gabrielDallape/minhoca-trail-system/hardware/placa_radio/saida/furos.csv

x_mm_lado_cobre | y_mm | broca_mm | o_que_e
31.00 | 3.40 | 1.0 | J3 entrada 5,3 V (-)
33.54 | 3.40 | 1.0 | J3 entrada 5,3 V (+)
4.00 | 5.00 | 0.8 | J2 pino 1 (TXEN)
6.00 | 5.00 | 0.8 | J2 pino 2 (NRST)
8.00 | 5.00 | 0.8 | J2 pino 3 (DIO1)
10.00 | 5.00 | 0.8 | J2 pino 4 (BUSY)
12.00 | 5.00 | 0.8 | J2 pino 5 (nao usado)
14.00 | 5.00 | 0.8 | J2 pino 6 (nao usado)
16.00 | 5.00 | 0.8 | J2 pino 7 (nao usado)
18.00 | 5.00 | 0.8 | J2 pino 8 (GND)
20.00 | 5.00 | 0.8 | J2 pino 9 (nao usado)
22.00 | 5.00 | 0.8 | J2 pino 10 (nao usado)
24.00 | 5.00 | 0.8 | J2 pino 11 (GND)
26.00 | 5.00 | 0.8 | J2 pino 12 (nao usado)
33.10 | 9.60 | 0.9 | C1 220uF (-)
35.60 | 9.60 | 0.9 | C1 220uF (+)
10.00 | 12.00 | 0.8 | JUMPER JP2 lado A (BUSY)
2.90 | 12.40 | 0.8 | JUMPER JP2 lado B (BUSY)
33.00 | 53.80 | 0.8 | JUMPER JP4 lado A (TERRA)
33.00 | 57.20 | 0.8 | JUMPER JP4 lado B (TERRA)
4.00 | 58.00 | 0.8 | J1 pino 1 (nao usado)
6.00 | 58.00 | 0.8 | J1 pino 2 (nao usado)
8.00 | 58.00 | 0.8 | J1 pino 3 (MISO)
10.00 | 58.00 | 0.8 | J1 pino 4 (SCK)
12.00 | 58.00 | 0.8 | J1 pino 5 (MOSI)
14.00 | 58.00 | 0.8 | J1 pino 6 (NSS)
16.00 | 58.00 | 0.8 | J1 pino 7 (RXEN)
18.00 | 58.00 | 0.8 | J1 pino 8 (GPS_TX)
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
