gabrielDallape/minhoca-trail-system/docs/img_lcd5_conectores.png

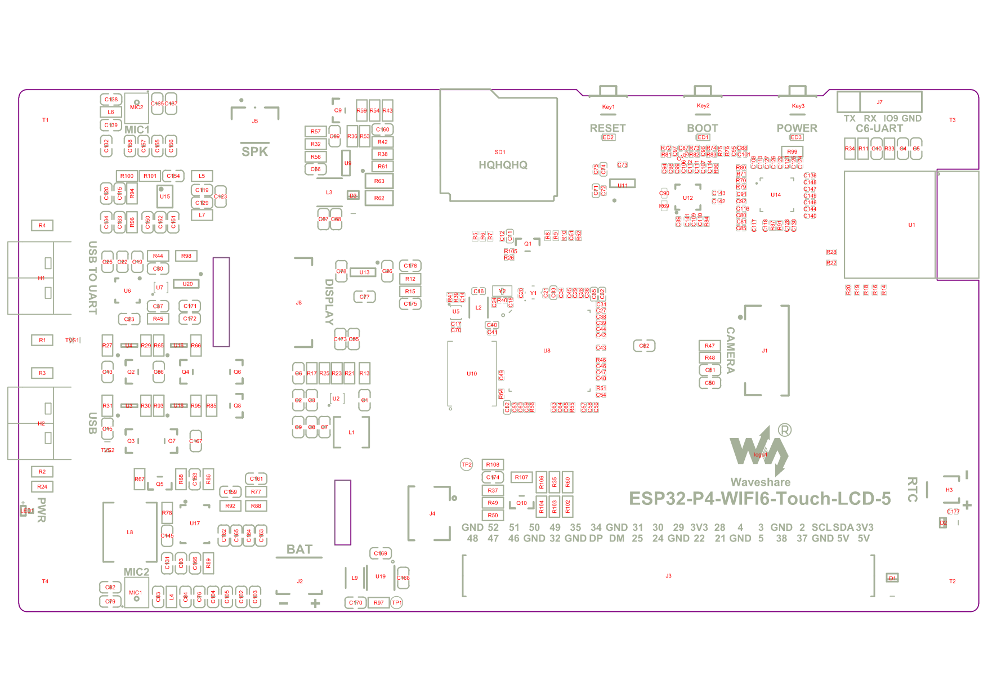
docs/img_lcd5_conectores.png
