gabrielDallape/minhoca-trail-system/docs/img_lcd7b_conectores.png

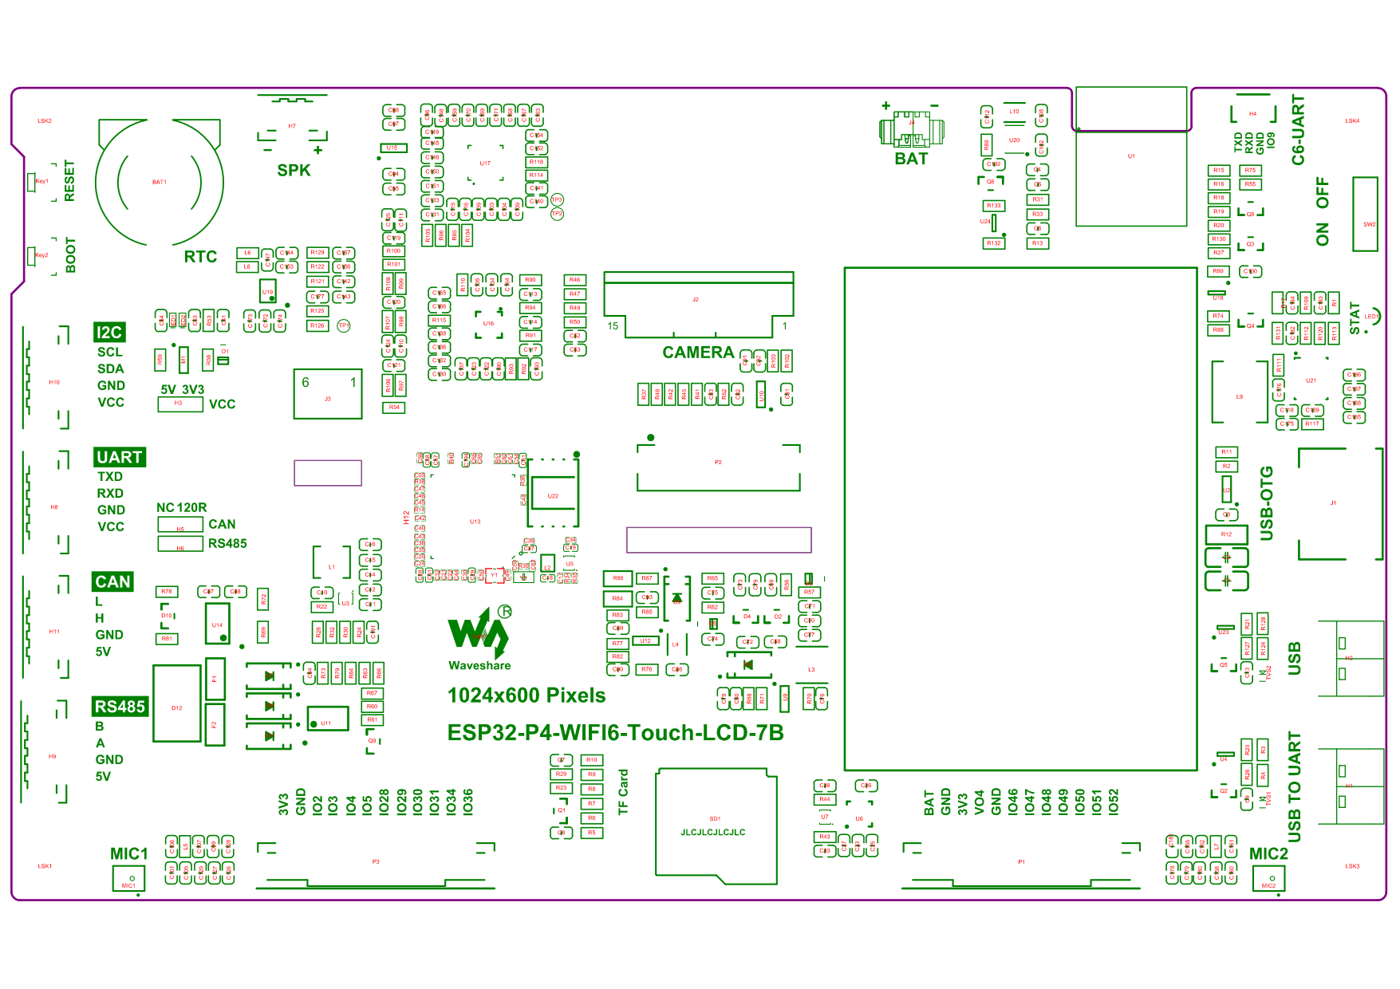
docs/img_lcd7b_conectores.png
