gabrielDallape/minhoca-trail-system/hardware/placa_radio/final/guia_4_placa_montada.png

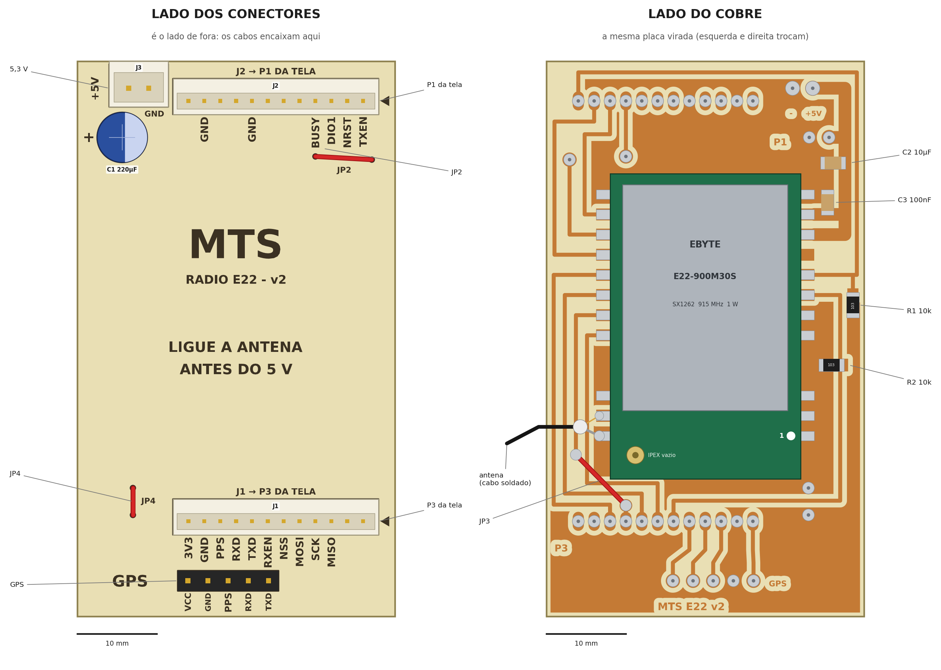
hardware/placa_radio/final/guia_4_placa_montada.png
