gabrielDallape/minhoca-trail-system/hardware/placa_radio/final/laser_queimar_bmp.bmp

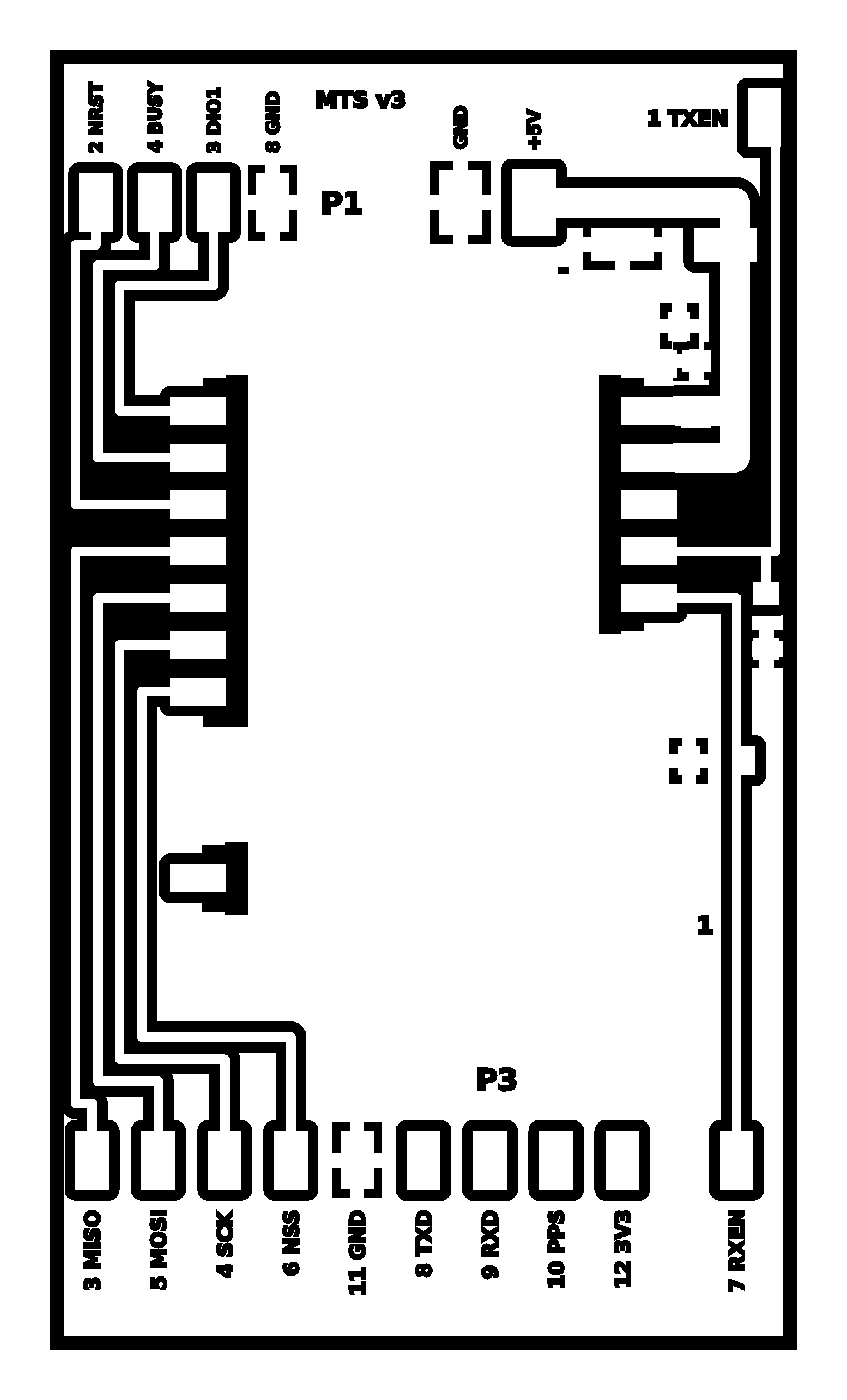
hardware/placa_radio/final/laser_queimar_bmp.bmp
