gabrielDallape/minhoca-trail-system/hardware/placa_radio/final/laser_serigrafia_bmp.bmp

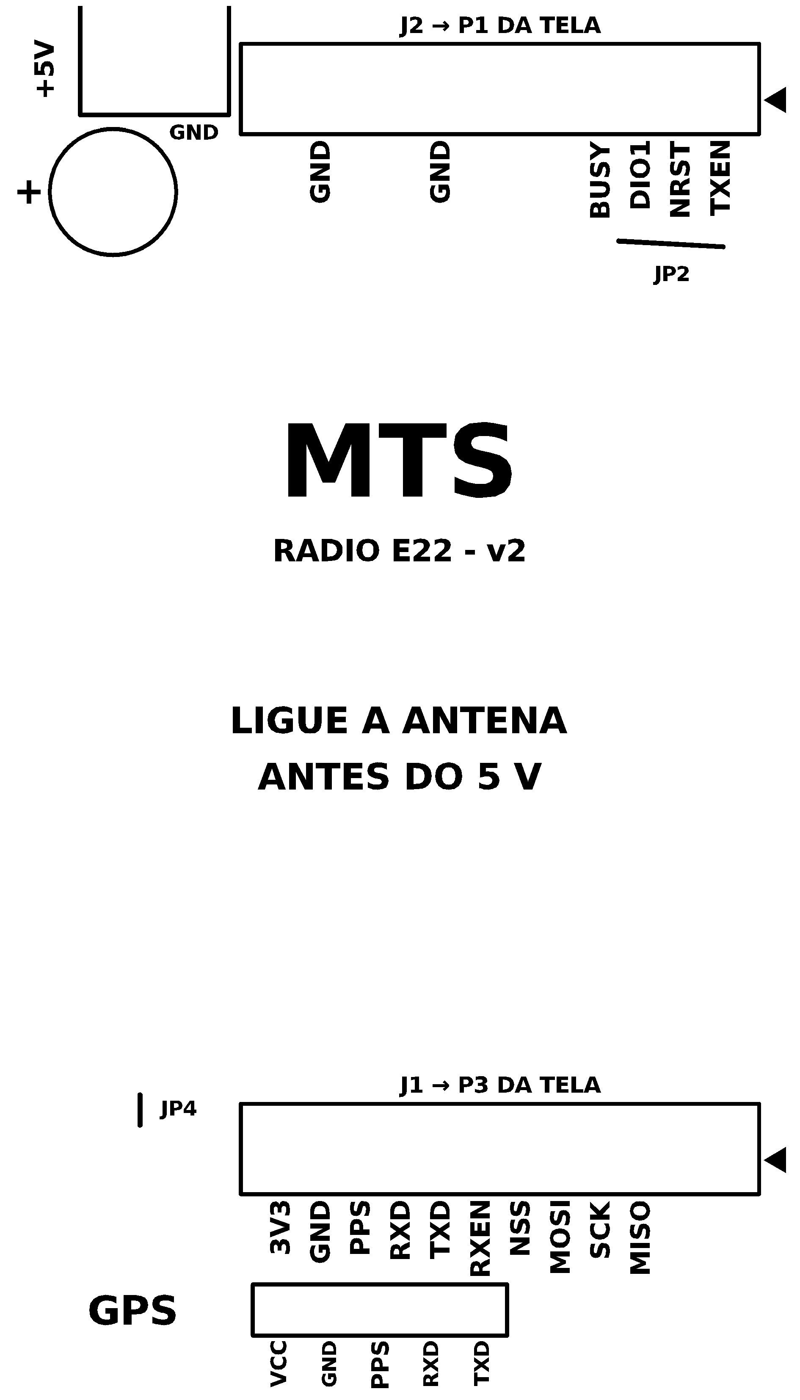
hardware/placa_radio/final/laser_serigrafia_bmp.bmp
