gabrielDallape/minhoca-trail-system/hardware/placa_radio/final/PREVIA_queimar_nao_gravar.png

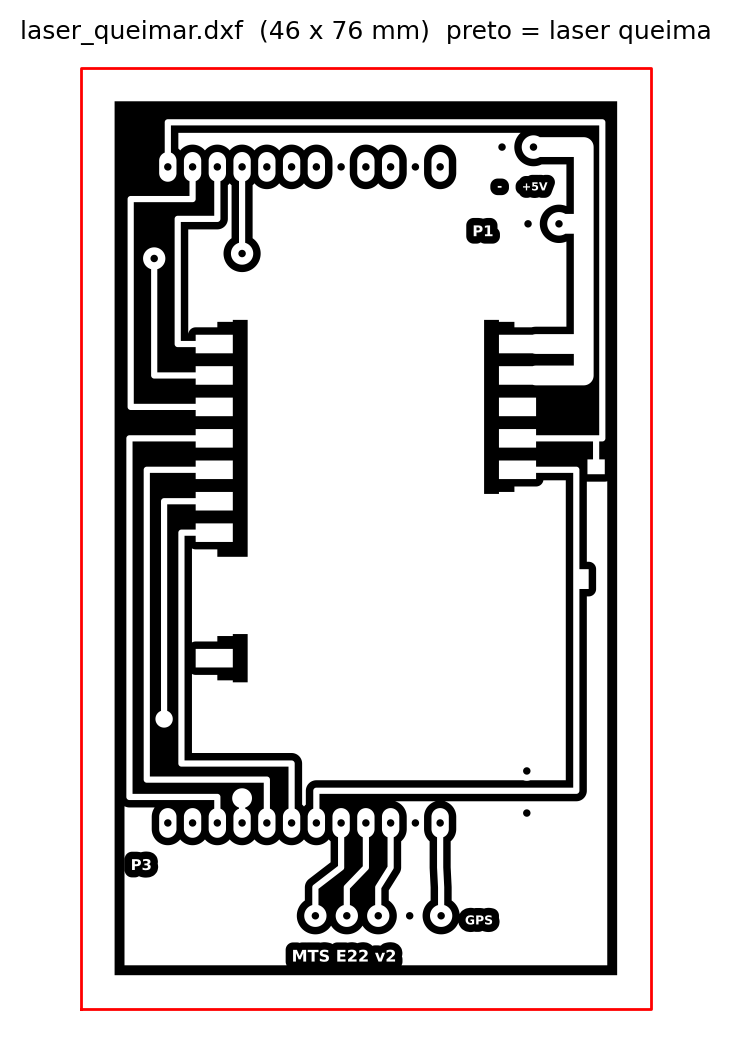
hardware/placa_radio/final/PREVIA_queimar_nao_gravar.png
