gabrielDallape/minhoca-trail-system/hardware/placa_radio/final/zoom_vao_e22.png

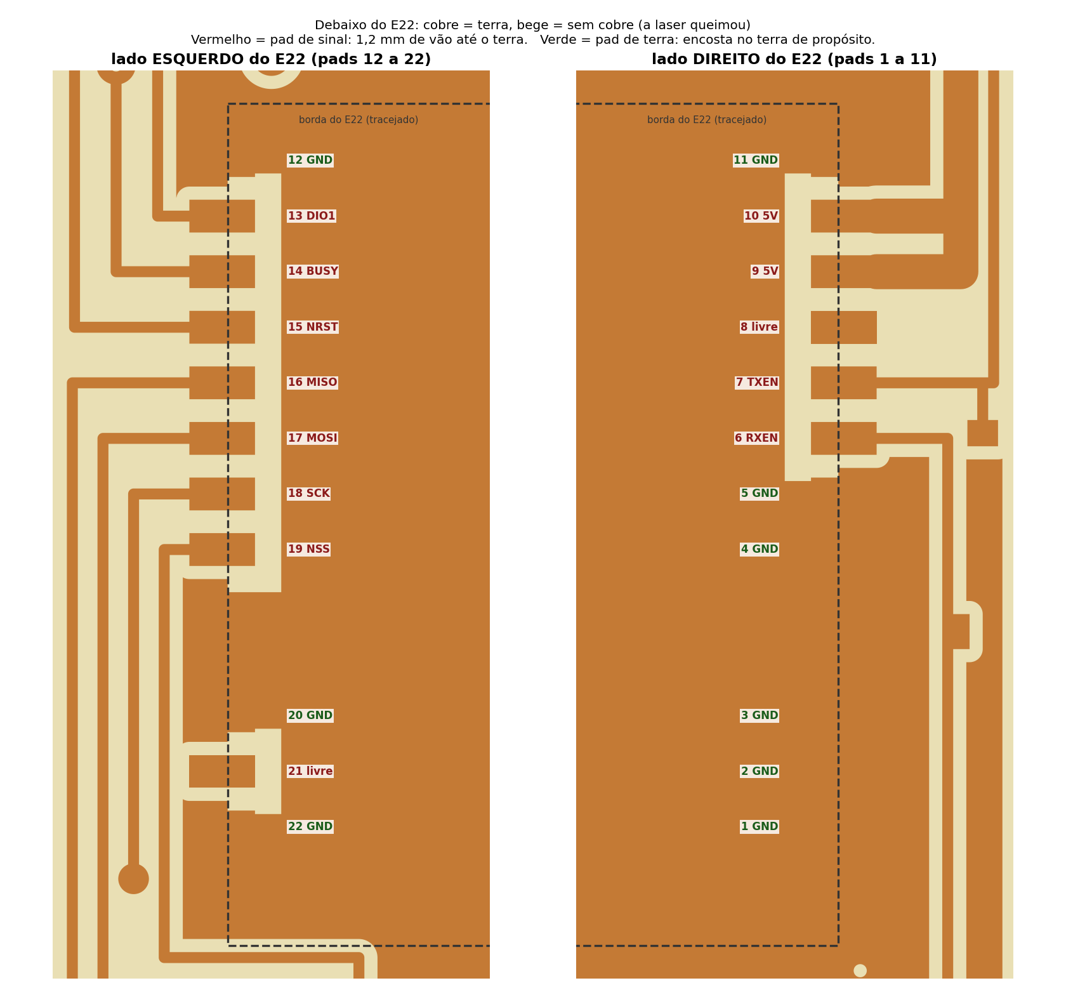
hardware/placa_radio/final/zoom_vao_e22.png
