gabrielDallape/minhoca-trail-system/hardware/placa_radio/saida/cobre.png

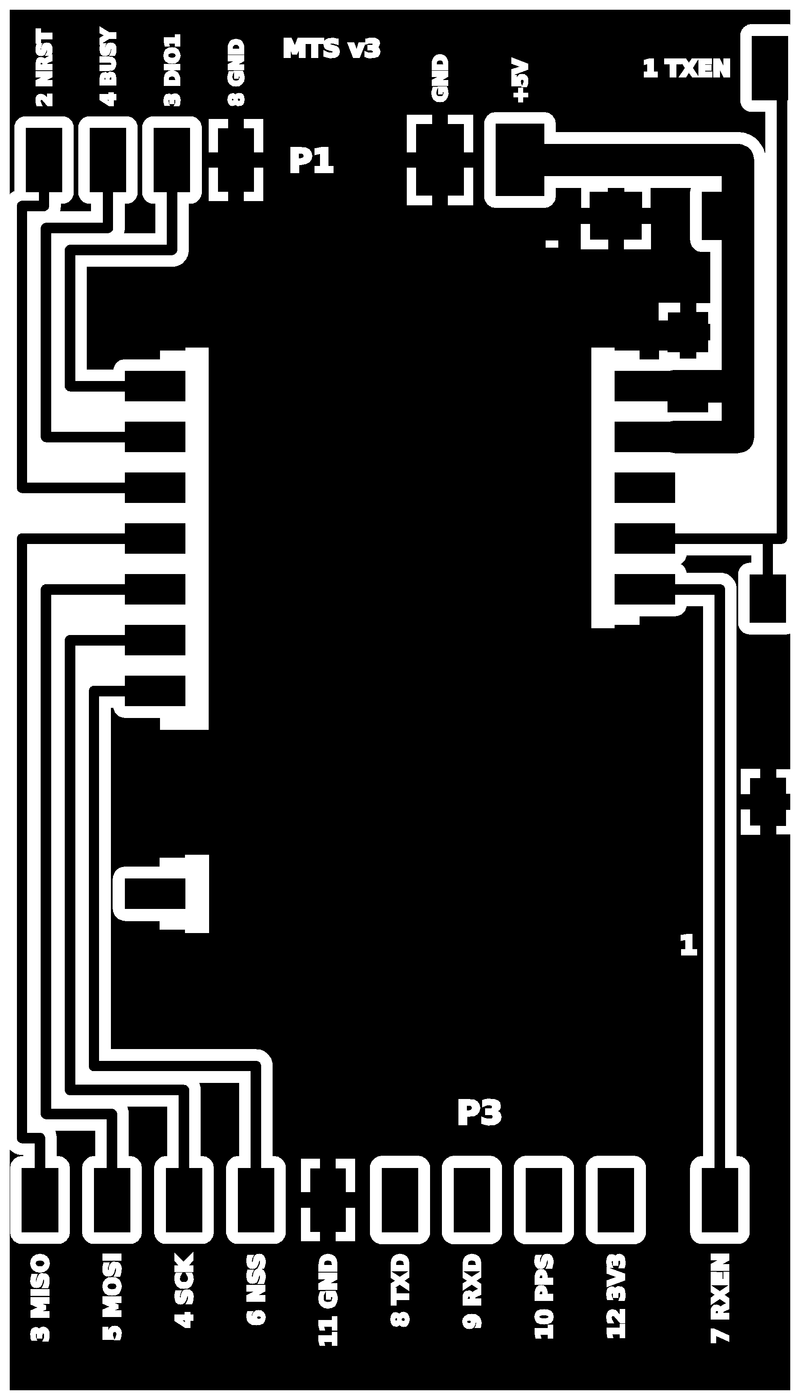
hardware/placa_radio/saida/cobre.png
