gabrielDallape/minhoca-trail-system/hardware/placa_radio/saida/conferencia_redes.png

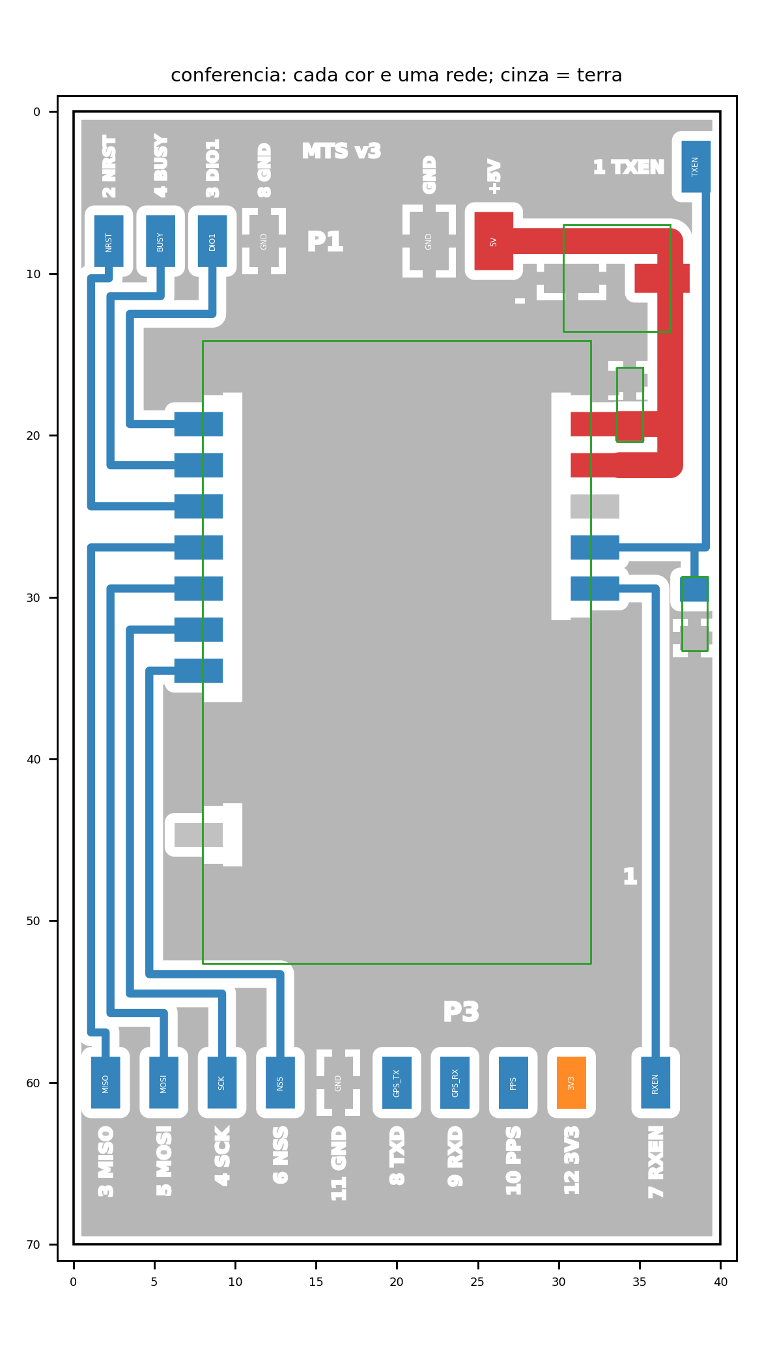
hardware/placa_radio/saida/conferencia_redes.png
