gabrielDallape/minhoca-trail-system/hardware/placa_radio/saida/guia_1_conectores.png

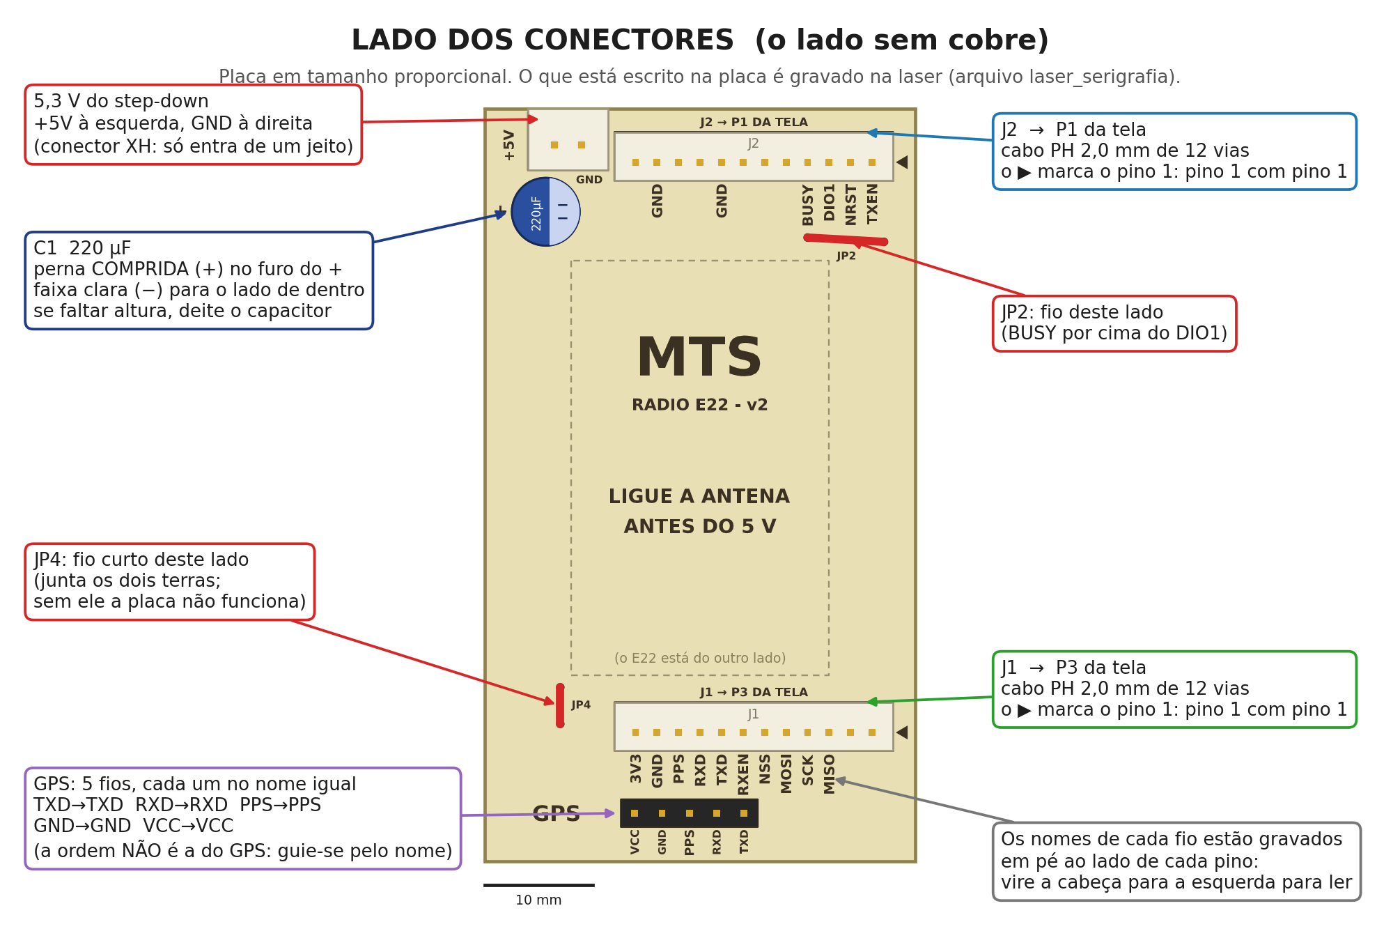
hardware/placa_radio/saida/guia_1_conectores.png
