gabrielDallape/minhoca-trail-system/hardware/placa_radio/saida/guia_2_lado_do_cobre.png

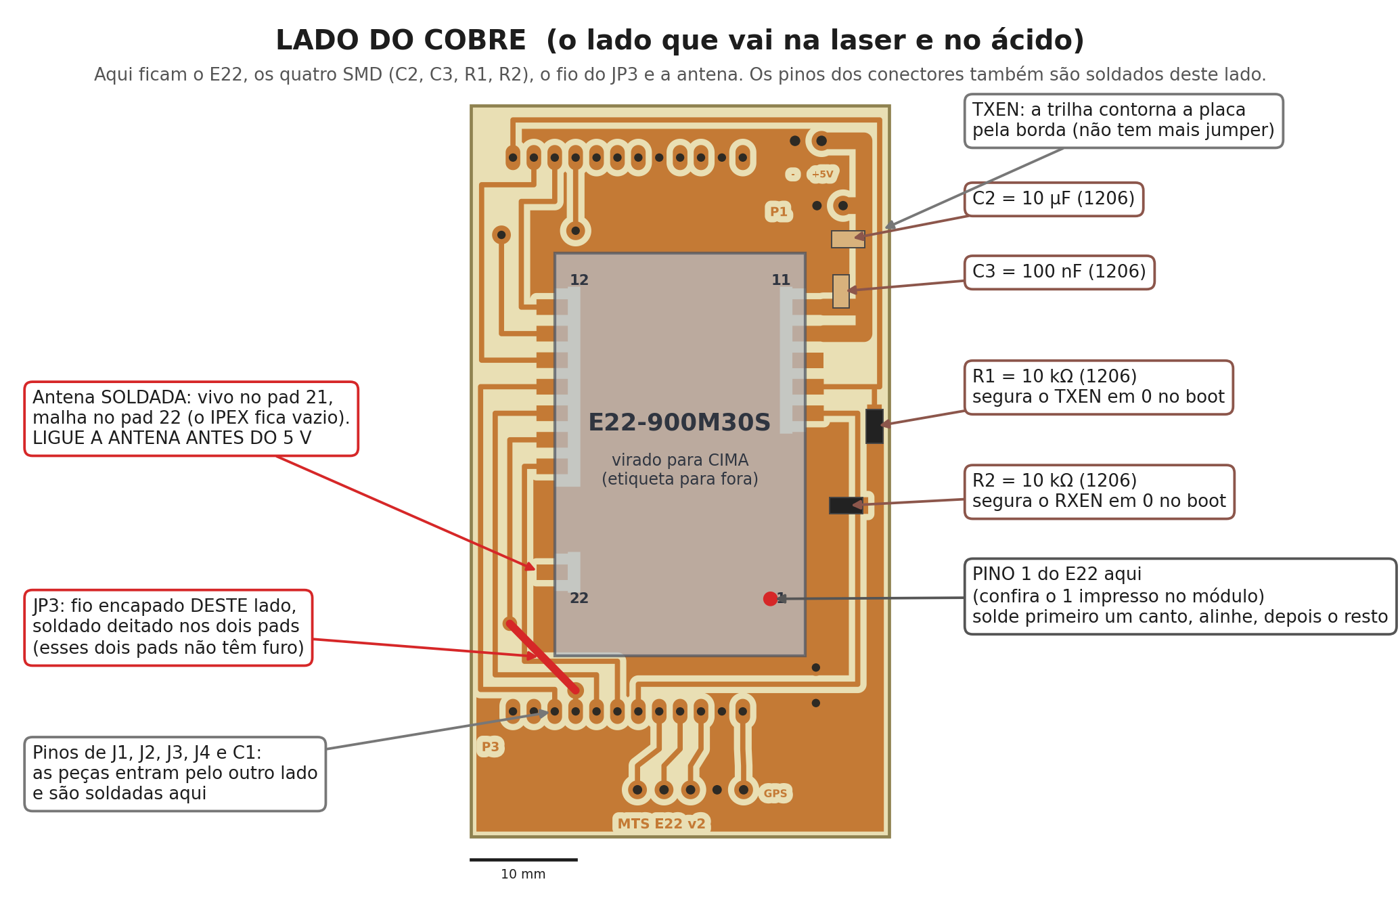
hardware/placa_radio/saida/guia_2_lado_do_cobre.png
