gabrielDallape/minhoca-trail-system/hardware/placa_radio/saida/guia_3_ligacoes.png

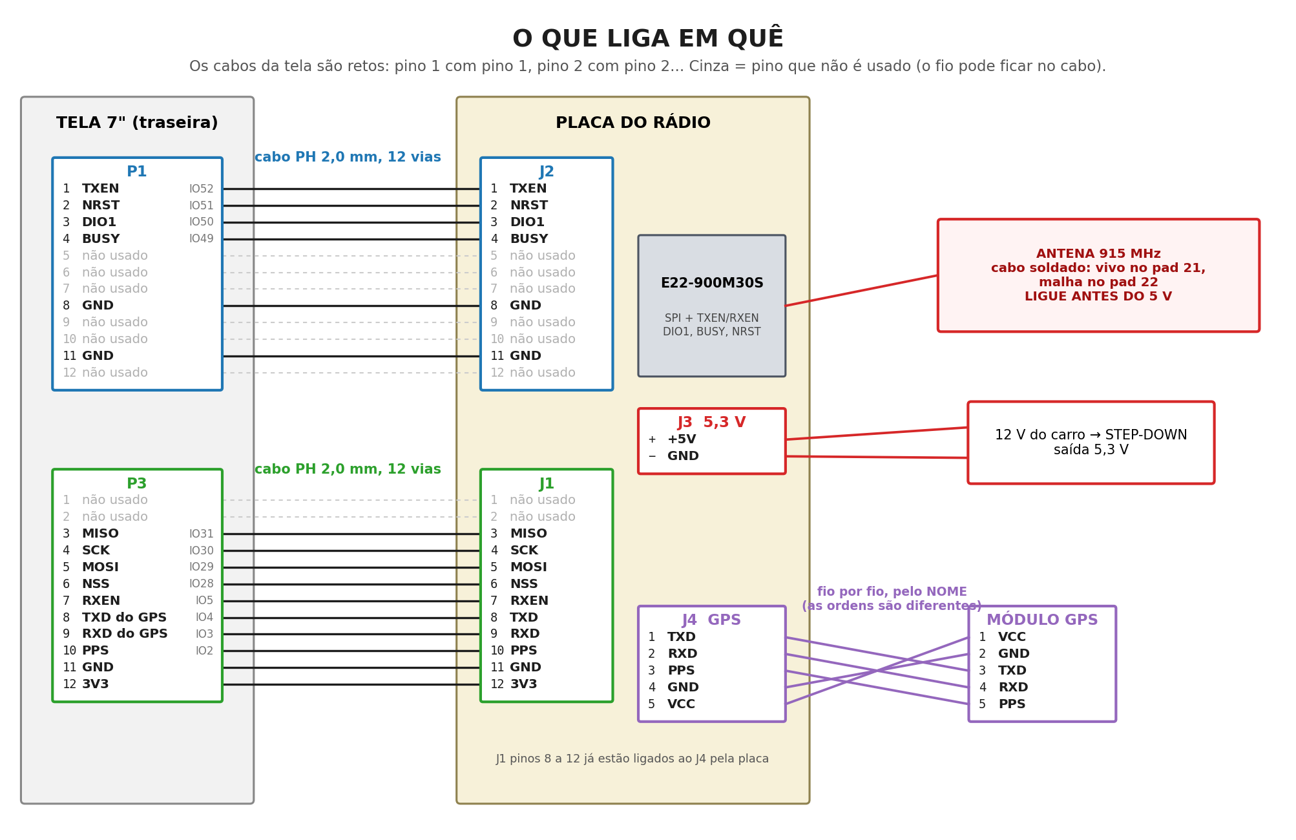
hardware/placa_radio/saida/guia_3_ligacoes.png
