gabrielDallape/minhoca-trail-system/hardware/placa_radio/saida/preview_laser_queimar_dxf.png

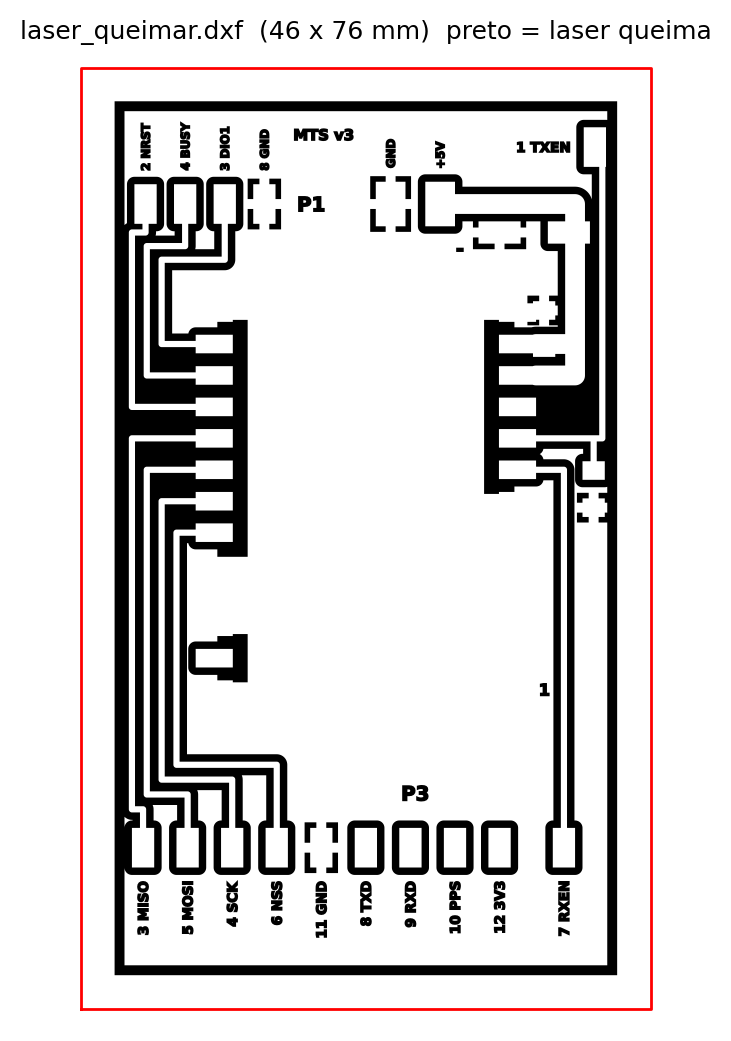
hardware/placa_radio/saida/preview_laser_queimar_dxf.png
