gabrielDallape/minhoca-trail-system/hardware/placa_radio/saida/preview_laser_serigrafia_dxf.png

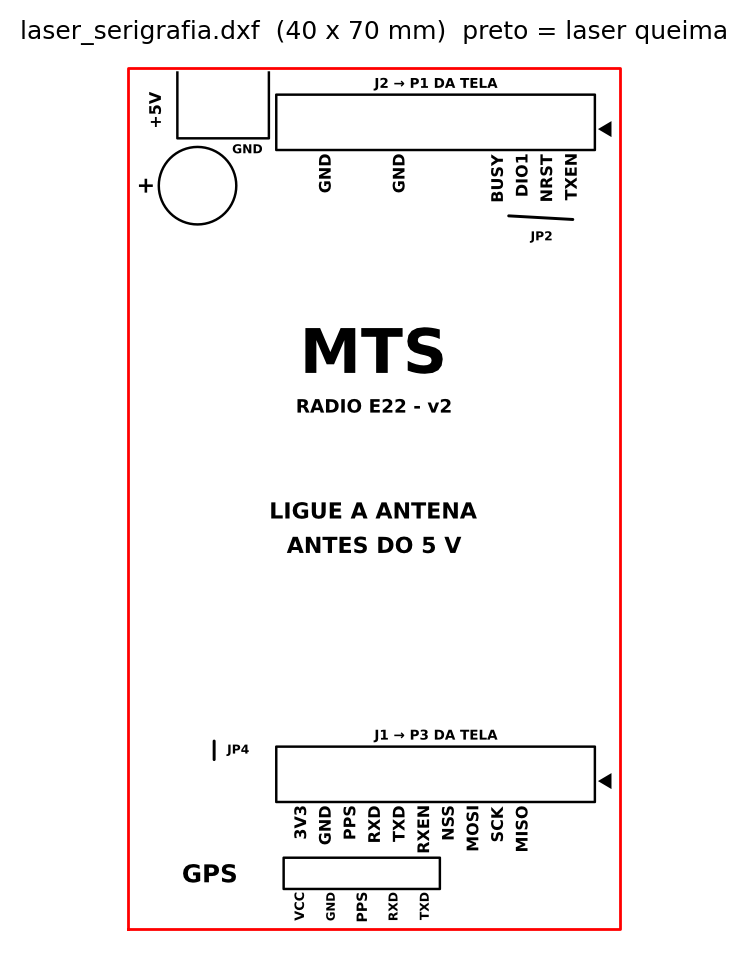
hardware/placa_radio/saida/preview_laser_serigrafia_dxf.png
