gabrielDallape/minhoca-trail-system/hardware/placa_radio/saida/regua_100mm.png

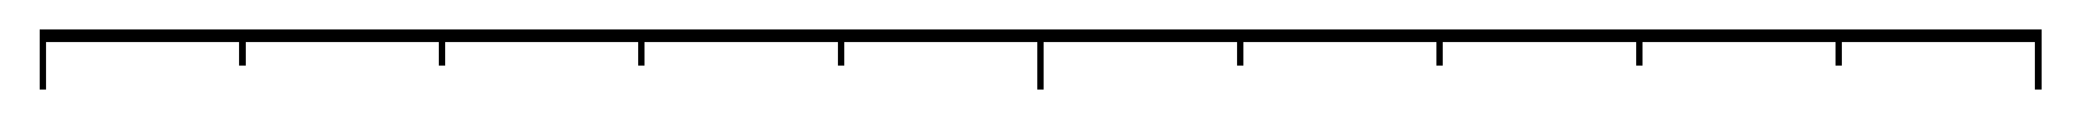
hardware/placa_radio/saida/regua_100mm.png
