gabrielDallape/minhoca-trail-system/hardware/placa_radio/final/laser_queimar.dxf

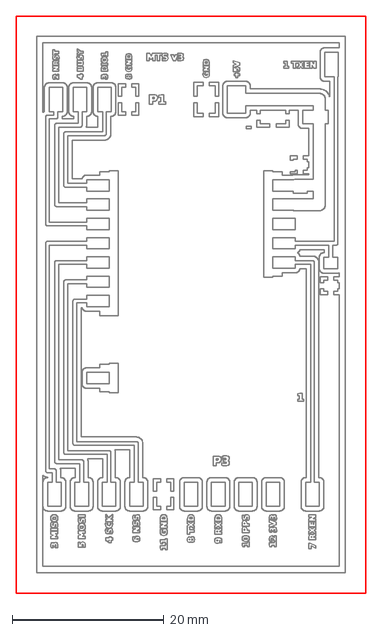
[picture p16: CAD file, 2026-10-02]
hardware/placa_radio/final/laser_queimar.dxf
46.0 x 76.0 mm
