gabrielDallape/minhoca-trail-system/hardware/placa_radio/saida/laser_queimar.dxf

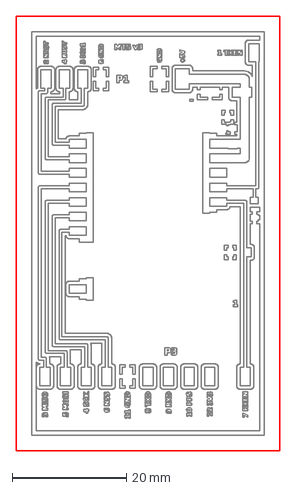
[picture p17: CAD file, 2026-10-02]
hardware/placa_radio/saida/laser_queimar.dxf
46.0 x 76.0 mm
