gabrielDallape/minhoca-trail-system/hardware/placa_radio/final/laser_serigrafia.dxf

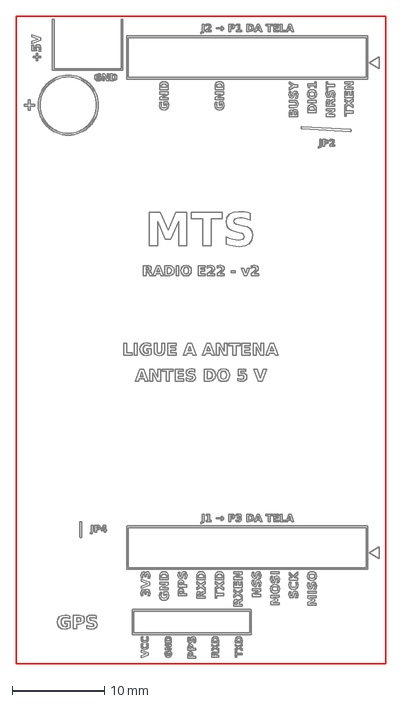
[picture p18: CAD file, 2026-10-01]
hardware/placa_radio/final/laser_serigrafia.dxf
40.0 x 70.0 mm
