gabrielDallape/minhoca-trail-system/hardware/placa_radio/saida/laser_serigrafia.dxf

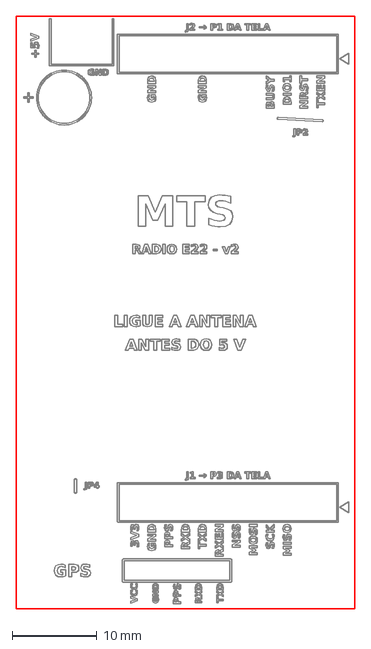
[picture p19: CAD file, 2026-10-01]
hardware/placa_radio/saida/laser_serigrafia.dxf
40.0 x 70.0 mm
