gabrielDallape/minhoca-trail-system/hardware/placa_radio/saida/montagem.png

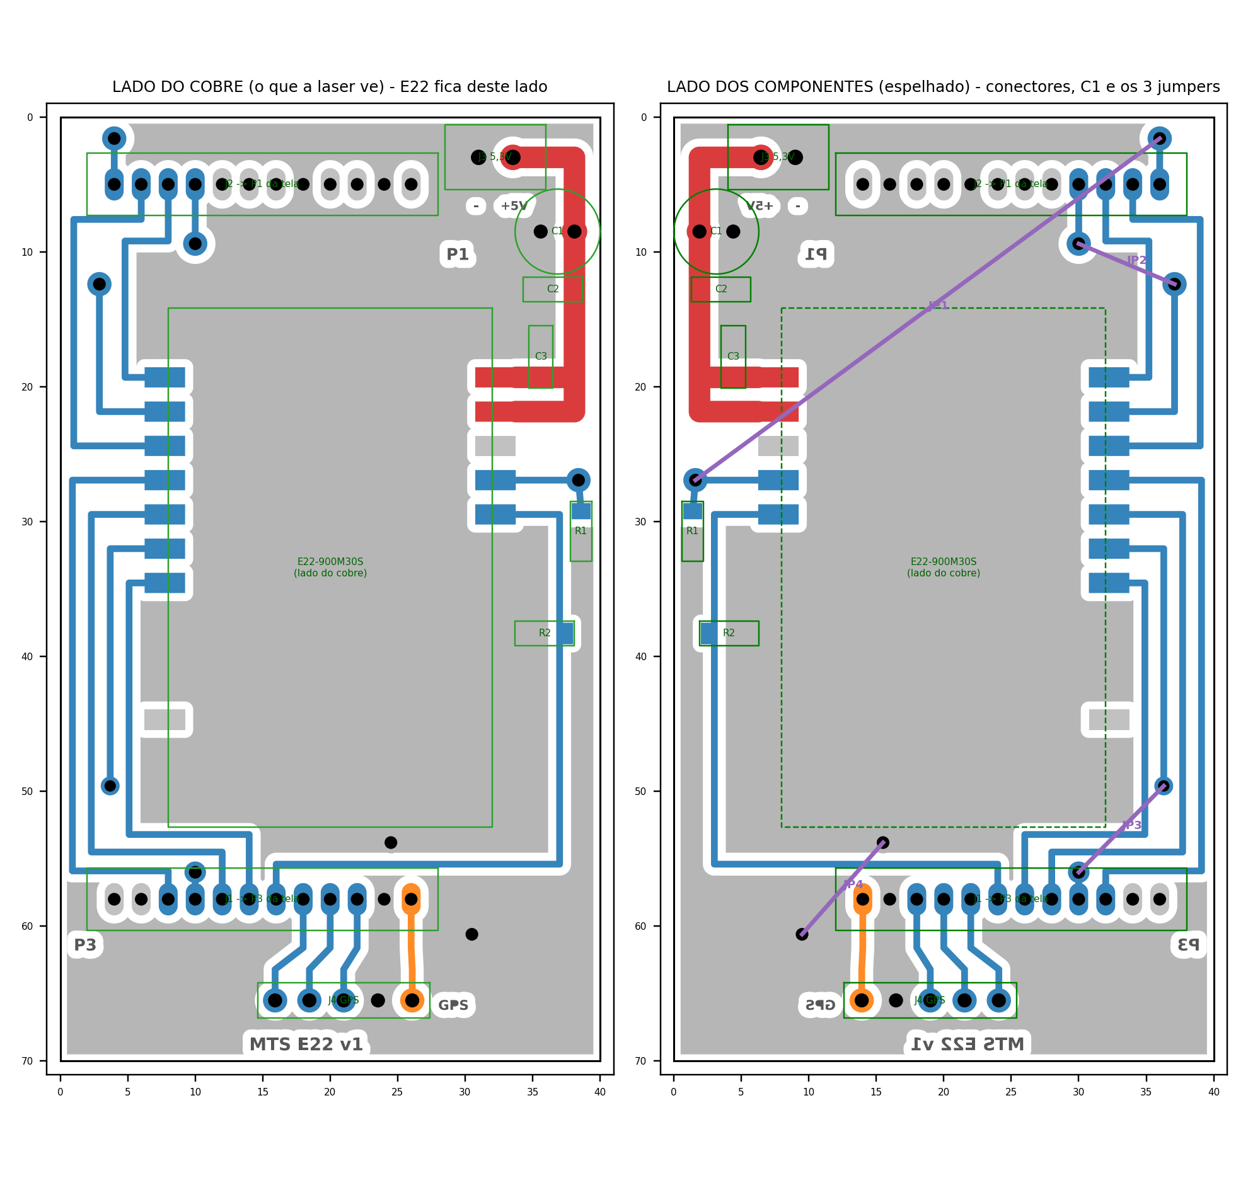
hardware/placa_radio/saida/montagem.png
