gabrielDallape/minhoca-trail-system/grupo_giga_follow/grupo_giga_follow.ino

/*
 * ============================================================================
 *  MODO GRUPO - SEGUIDOR no GIGA R1 (reserva / p/ bench-testar com o CYD).
 *  Mesmo protocolo do grupo/grupo.ino, mas render em GigaDisplay_GFX (paisagem).
 *  So SEGUIDOR (o lider e sempre o CYD/Waveshare). Config por serial:
 *    'R' 5dig -> sala (ex.: "R48291")   'F' n -> meu slot (1..7, ex.: "F1")
 *  LoRa -> Serial2 (18/19) ; GPS -> Serial1 (0/1).
 *  Recebe CMD_WORLD(0x30) e CMD_ROSTER(0x31) do lider; faz uplink CMD_UPLINK(0x32)
 *  na sua vez (slot = worldRx + slot*450ms). Mapa: voce=triangulo azul,
 *  lider=triangulo amarelo, outros=bolinhas; alerta=estrada vermelha.
 * ============================================================================
 */
#include <TinyGPSPlus.h>
#include "Arduino_GigaDisplay_GFX.h"
#include "Arduino_GigaDisplayTouch.h"
#include "LoRaMESH.h"
#include <Fonts/FreeSans9pt7b.h>
#include <Fonts/FreeSans12pt7b.h>
#include <Fonts/FreeSansBold12pt7b.h>
#include <Fonts/FreeSansBold18pt7b.h>
#include <Fonts/FreeSansBold24pt7b.h>
#include <kvstore_global_api.h>   // memoria persistente do GIGA (mbed)

GigaDisplay_GFX          gfx;
Arduino_GigaDisplayTouch touch;
TinyGPSPlus  gps;
LoRaMESH     lora(&Serial2);

const uint16_t BCAST=2047, LEADER_ID=0;
const uint8_t  CMD_WORLD=0x30, CMD_ROSTER=0x31, CMD_UPLINK=0x32, CMD_JOIN=0x33;
#define BANCADA 0   // 0 = GPS REAL (teste de rua). 1 = bancada (posicao fake).
#define P2P 1        // modo PONTO-A-PONTO (1:1), sem broadcast/flooding
#define P2P_CMD 0x11    // seguidor->lider: so posicao
#define P2P_TRAIL 0x12  // lider->seguidor: posicao + TRAJETO (breadcrumb do caminho do lider)
#define PEER_ID 1    // GIGA (id0) fala DIRETO com a Waveshare (modulo antigo 13683 = id1)
unsigned long lastP2PTx=0;
const int      MAXN=8, ROUTE_MAX=140, HIST_N=12;
const double   R_EARTH=6371000.0;
const unsigned long SLOT_MS=450, CYCLE_MS=(unsigned long)MAXN*SLOT_MS, NODE_TTL=15000, LEAD_TTL=8000;

// config. room 0 = nao configurado -> tela inicial Criar/Entrar
uint32_t room=0; uint8_t mySlot=1;
char codeBuf[6]=""; int codeLen=0;
bool leaderRole=false; uint16_t routeSeq=0; unsigned long lastCycle=0; double lastAddLat=0,lastAddLon=0; bool haveAdd=false;
uint8_t uiPage=0, pendingRole=0; bool searching=false;   // seguidor procurando a sala existir
bool editName=false; char nameBuf[16]="";                // edicao do nome do aparelho

// mundo
struct Node{ bool active; double lat,lon; bool fix; bool alert; unsigned long lastMs; uint8_t color; };
Node world[MAXN];
struct Geo{ double lat,lon; }; Geo route[ROUTE_MAX]; int routeN=0,routeHead=0; uint16_t lastRouteSeq=0; bool haveRouteSeq=false;
char rname[MAXN][16]; uint8_t rcolor[MAXN]; uint32_t ruid[MAXN]; bool haveRoster=false;
uint32_t myUid=0; bool joined=false; uint8_t curSlot=0; uint8_t myColor=1; char myName[16]="Carro";
void saveName(){ kv_set("dev_name", myName, strlen(myName)+1, 0); }
void loadName(){ char b[16]; size_t a=0; if(kv_get("dev_name", b, sizeof(b), &a)==0 && a>0){ b[15]=0; strncpy(myName,b,15); myName[15]=0; } }

double myLat=0,myLon=0; bool myFix=false; int mySats=0; float mySpeed=0,myHeading=0;
unsigned long myLastFix=0, worldRxMs=0, slotDue=0, lastDraw=0, lastDbg=0;
bool pendingUplink=false, myAlert=false; unsigned long myAlertUntil=0;
float mapMPP=2.0f; bool touchWasDown=false;

// cores viram VARIAVEIS de tema (setadas por applyTheme) -> resto do desenho nao muda
uint16_t C_BG,C_CARD,C_LINE,C_BLUE,C_AMBER,C_ROUTE,C_ROUTEC,C_TRAV,C_TRAVC,C_RED,C_MUT,C_YEL;
const uint16_t C_WHITE=0xFFFF;
uint8_t C_FL;   // flags de estilo do tema
#define FL_CORNERS 1
#define FL_GRID    2
#define FL_CROSS   4
#define RGB(r,g,b) ((uint16_t)((((r)&0xF8)<<8)|(((g)&0xFC)<<3)|((b)>>3)))
struct Theme{ uint16_t bg,card,line,you,leader,route,routec,trav,travc,red,mut; uint8_t fl; const char* name; };
const Theme THEMES[3]={
 { RGB(11,9,6),   RGB(29,24,16), RGB(61,49,25), RGB(40,216,255),  RGB(255,210,62),  RGB(255,149,0),  RGB(90,58,0),  RGB(90,70,34), RGB(50,40,20), RGB(255,59,48), RGB(179,155,111), FL_CORNERS,        "RALLY" },
 { RGB(10,13,9),  RGB(21,27,16), RGB(47,61,32), RGB(232,255,207), RGB(255,122,26),  RGB(166,255,77), RGB(40,70,18), RGB(60,74,42), RGB(35,45,26), RGB(255,47,32), RGB(127,144,104),FL_GRID|FL_CROSS,  "TATICO" },
 { RGB(10,12,16), RGB(24,30,38), RGB(32,42,52), RGB(0,229,255),   RGB(255,255,255), RGB(0,229,255),  RGB(16,50,60), RGB(38,66,74), RGB(28,46,52), RGB(255,56,96), RGB(102,114,126),0,                 "HUD" },
};
int themeIdx=0;
void applyTheme(int i){ if(i<0||i>2)i=0; themeIdx=i; const Theme&t=THEMES[i];
  C_BG=t.bg;C_CARD=t.card;C_LINE=t.line;C_BLUE=t.you;C_AMBER=t.leader;C_ROUTE=t.route;C_ROUTEC=t.routec;C_TRAV=t.trav;C_TRAVC=t.travc;C_RED=t.red;C_MUT=t.mut;C_YEL=0xFE60;C_FL=t.fl; }
void saveTheme(){ uint8_t t=(uint8_t)themeIdx; kv_set("dev_theme",&t,1,0); }
void loadTheme(){ uint8_t t=0; size_t a=0; if(kv_get("dev_theme",&t,1,&a)==0&&a>0&&t<3) themeIdx=t; }
const double OFFROUTE_M=30.0;
static const uint16_t PALETTE[8]={0x3C7F,0x2CF1,0x9694,0xEC88,0xE36E,0x2648,0xFD20,0x07FF};
uint16_t colorOf(uint8_t i){ return PALETTE[i&7]; }

int SCR_W,SCR_H,CXp,CYp, abX,abY,abR;
int zpX,zpY,zmX,zmY,zSz;   // botoes de zoom + / -

double haversine(double la1,double lo1,double la2,double lo2){
  double dLa=radians(la2-la1),dLo=radians(lo2-lo1);
  double a=sin(dLa/2)*sin(dLa/2)+cos(radians(la1))*cos(radians(la2))*sin(dLo/2)*sin(dLo/2);
  return R_EARTH*2*atan2(sqrt(a),sqrt(1-a));
}
void w2s(double lat,double lon,double clat,double clon,double head,int&sx,int&sy){
  double east=R_EARTH*cos(radians(clat))*radians(lon-clon), north=R_EARTH*radians(lat-clat);
  double h=radians(head), up=north*cos(h)+east*sin(h), ri=east*cos(h)-north*sin(h);
  sx=CXp+(int)(ri/mapMPP); sy=CYp-(int)(up/mapMPP);
}
int32_t getLE32(const uint8_t*p){ return (int32_t)((uint32_t)p[0]|((uint32_t)p[1]<<8)|((uint32_t)p[2]<<16)|((uint32_t)p[3]<<24)); }
void putLE32(uint8_t*p,int32_t v){ p[0]=v&0xFF;p[1]=(v>>8)&0xFF;p[2]=(v>>16)&0xFF;p[3]=(v>>24)&0xFF; }
uint32_t roomOf(const uint8_t*p){ return (uint32_t)p[0]|((uint32_t)p[1]<<8)|((uint32_t)p[2]<<16); }
void routeAdd(double la,double lo){ route[routeHead].lat=la; route[routeHead].lon=lo; routeHead=(routeHead+1)%ROUTE_MAX; if(routeN<ROUTE_MAX)routeN++; }

void handleSerial(){
  if(!Serial.available()) return; char c=Serial.read();
  if(c=='R'){ uint32_t v=0; for(int i=0;i<5;i++){ while(!Serial.available()){} char d=Serial.read(); if(d>='0'&&d<='9')v=v*10+(d-'0'); } room=v; Serial.print("sala="); Serial.println(room); }
  else if(c=='F'){ while(!Serial.available()){} int n=Serial.read()-'0'; if(n>=1&&n<MAXN){ curSlot=n; joined=true; leaderRole=false; searching=false; Serial.print("slot="); Serial.println(curSlot);} }
  else if(c=='L'){ leaderRole=true; if(room==0)room=48291; curSlot=0; joined=true; searching=false; ruid[0]=myUid; strncpy(rname[0],myName,15); rname[0][15]=0; rcolor[0]=myColor; haveRoster=true; Serial.println("LIDER"); }
  else if(c=='X'){ room=0; uiPage=0; leaderRole=false; joined=false; searching=false; codeLen=0; codeBuf[0]=0; Serial.println("saiu"); }
}

void readGPS(){
  while(Serial1.available()) gps.encode(Serial1.read());
  if(gps.satellites.isValid()) mySats=gps.satellites.value();
  if(gps.speed.isValid()) mySpeed=gps.speed.kmph();
  if(gps.course.isValid() && mySpeed>=1.5f) myHeading=gps.course.deg();
  if(gps.location.isValid() && gps.location.isUpdated()){ myLat=gps.location.lat(); myLon=gps.location.lng(); myLastFix=millis(); }
  myFix=(myLastFix!=0)&&(millis()-myLastFix<3000);
}
void sendUplink(){
  uint8_t p[13]; int o=0; p[o++]=room&0xFF;p[o++]=(room>>8)&0xFF;p[o++]=(room>>16)&0xFF; p[o++]=curSlot;
  uint8_t fl=0; if(myFix)fl|=2; if(myAlert)fl|=4; p[o++]=fl;
  putLE32(p+o,(int32_t)(myLat*1e7)); o+=4; putLE32(p+o,(int32_t)(myLon*1e7)); o+=4;
  lora.PrepareFrameCommand(LEADER_ID,CMD_UPLINK,p,o); lora.SendPacket();
}
void sendJoin(){
  uint8_t p[24]; int o=0; p[o++]=room&0xFF;p[o++]=(room>>8)&0xFF;p[o++]=(room>>16)&0xFF;
  putLE32(p+o,(int32_t)myUid); o+=4; p[o++]=myColor; int L=strlen(myName); if(L>15)L=15; p[o++]=(uint8_t)L; memcpy(p+o,myName,L); o+=L;
  lora.PrepareFrameCommand(LEADER_ID,CMD_JOIN,p,o); lora.SendPacket();
}
// P2P: manda MINHA posicao+alerta DIRETO pro peer (unicast)
void sendP2P(){ uint8_t p[10]; uint8_t fl=0; if(myFix)fl|=1; if(myAlert)fl|=2; p[0]=fl;
  putLE32(p+1,(int32_t)(myLat*1e7)); putLE32(p+5,(int32_t)(myLon*1e7));
  lora.PrepareFrameCommand(PEER_ID,P2P_CMD,p,9); lora.SendPacket(); }
// P2P LIDER: manda posicao + TRAJETO (ultimos pontos do caminho) unicast pro seguidor
#define TRAIL_N 24   // ultimos N pontos do trajeto por pacote (~120m de cobertura contra perda de sinal). 13+24*8=205B < 232
void sendTrail(){ uint8_t p[13+TRAIL_N*8]; int o=0;
  uint8_t fl=0; if(myFix)fl|=1; if(myAlert)fl|=2; p[o++]=fl;
  putLE32(p+o,(int32_t)(myLat*1e7)); o+=4; putLE32(p+o,(int32_t)(myLon*1e7)); o+=4;   // posicao atual do lider
  int nh=routeN<TRAIL_N?routeN:TRAIL_N; p[o++]=(uint8_t)nh; p[o++]=routeSeq&0xFF; p[o++]=(routeSeq>>8)&0xFF;
  int idx=(routeHead-nh+ROUTE_MAX)%ROUTE_MAX;
  for(int i=0;i<nh;i++){ int j=(idx+i)%ROUTE_MAX; putLE32(p+o,(int32_t)(route[j].lat*1e7)); o+=4; putLE32(p+o,(int32_t)(route[j].lon*1e7)); o+=4; }
  lora.PrepareFrameCommand(PEER_ID,P2P_TRAIL,p,o); lora.SendPacket(); }
// ---- LIDER: broadcast do mundo + roster ----
void sendWorld(){
  uint8_t p[4+8+72+3+HIST_N*8]; int o=0;
  p[o++]=room&0xFF; p[o++]=(room>>8)&0xFF; p[o++]=(room>>16)&0xFF; p[o++]=(uint8_t)(millis()/CYCLE_MS);
  for(int k=0;k<MAXN;k++) p[o++]=rcolor[k];
  for(int k=0;k<MAXN;k++){ uint8_t fl=0; if(world[k].active)fl|=1; if(world[k].fix)fl|=2; if(world[k].alert)fl|=4;
    p[o++]=fl; putLE32(p+o,(int32_t)(world[k].lat*1e7)); o+=4; putLE32(p+o,(int32_t)(world[k].lon*1e7)); o+=4; }
  int nh=routeN<HIST_N?routeN:HIST_N; p[o++]=(uint8_t)nh; p[o++]=routeSeq&0xFF; p[o++]=(routeSeq>>8)&0xFF;
  int idx=(routeHead-nh+ROUTE_MAX)%ROUTE_MAX;
  for(int i=0;i<nh;i++){ int j=(idx+i)%ROUTE_MAX; putLE32(p+o,(int32_t)(route[j].lat*1e7)); o+=4; putLE32(p+o,(int32_t)(route[j].lon*1e7)); o+=4; }
  lora.PrepareFrameCommand(BCAST,CMD_WORLD,p,o); lora.SendPacket();
}
void sendRoster(){
  uint8_t p[3+MAXN*21]; int o=0; p[o++]=room&0xFF; p[o++]=(room>>8)&0xFF; p[o++]=(room>>16)&0xFF;
  for(int k=0;k<MAXN;k++){ putLE32(p+o,(int32_t)ruid[k]); o+=4; p[o++]=rcolor[k]; int L=strlen(rname[k]); if(L>15)L=15; p[o++]=(uint8_t)L; memcpy(p+o,rname[k],L); o+=L; }
  lora.PrepareFrameCommand(BCAST,CMD_ROSTER,p,o); lora.SendPacket();
}
void leaderRecordOwnPath(){
  if(myFix && (!haveAdd || haversine(lastAddLat,lastAddLon,myLat,myLon)>=5.0)){ routeAdd(myLat,myLon); routeSeq++; lastAddLat=myLat; lastAddLon=myLon; haveAdd=true; }
}
void handleRx(uint8_t cmd,uint8_t*p,uint8_t plen){
  if(leaderRole){   // LIDER: recebe uplink e join
    if(cmd==CMD_UPLINK && plen>=13 && roomOf(p)==room){ uint8_t sl=p[3]; if(sl>=1&&sl<MAXN){
      uint8_t fl=p[4]; world[sl].active=true; world[sl].fix=fl&2; world[sl].alert=fl&4;
      world[sl].lat=getLE32(p+5)/1e7; world[sl].lon=getLE32(p+9)/1e7; world[sl].lastMs=millis(); } }
    else if(cmd==CMD_JOIN && plen>=9 && roomOf(p)==room){
      uint32_t uid=(uint32_t)getLE32(p+3); uint8_t col=p[7]; int L=p[8]; if(L>15)L=15;
      char nm[16]; if(9+L<=plen){ memcpy(nm,p+9,L); nm[L]=0; } else nm[0]=0;
      int slot=-1; for(int k=1;k<MAXN;k++) if(ruid[k]==uid){ slot=k; break; }
      if(slot<0) for(int k=1;k<MAXN;k++) if(ruid[k]==0){ slot=k; break; }
      if(slot>=1){ ruid[slot]=uid; if(col<8)rcolor[slot]=col; if(nm[0]){ strncpy(rname[slot],nm,15); rname[slot][15]=0; } haveRoster=true; sendRoster(); }
    }
    return;
  }
  if(cmd==CMD_ROSTER && plen>=3 && roomOf(p)==room){
    int o=3; for(int k=0;k<MAXN&&o+6<=plen;k++){ ruid[k]=(uint32_t)getLE32(p+o); o+=4; rcolor[k]=p[o++]; int L=p[o++]; if(L>15)L=15; if(o+L>plen)break; memcpy(rname[k],p+o,L); rname[k][L]=0; o+=L; }
    haveRoster=true;
    if(!joined){ for(int k=1;k<MAXN;k++) if(ruid[k]==myUid){ curSlot=k; joined=true; break; } }
    return;
  }
  if(cmd==CMD_WORLD && plen>=4+8+72+3 && roomOf(p)==room){
    worldRxMs=millis(); searching=false; int o=4;   // achou a sala (ouviu o lider)
    for(int k=0;k<MAXN;k++) world[k].color=p[o++];
    for(int k=0;k<MAXN;k++){ uint8_t fl=p[o]; world[k].active=fl&1; world[k].fix=fl&2; world[k].alert=fl&4;
      world[k].lat=getLE32(p+o+1)/1e7; world[k].lon=getLE32(p+o+5)/1e7; if(world[k].active) world[k].lastMs=millis(); o+=9; }
    int nh=p[o++]; uint16_t seqN=(uint16_t)p[o]|((uint16_t)p[o+1]<<8); o+=2;
    for(int i=0;i<nh;i++){ double la=getLE32(p+o)/1e7, lo=getLE32(p+o+4)/1e7; o+=8;
      uint16_t seq=seqN-(nh-1)+i; if(!haveRouteSeq||(int16_t)(seq-lastRouteSeq)>0){ routeAdd(la,lo); lastRouteSeq=seq; haveRouteSeq=true; } }
    slotDue=worldRxMs+(unsigned long)curSlot*SLOT_MS; pendingUplink=true;
  }
}
void readLoRa(){ int g=0; uint16_t id; uint8_t cmd=0,p[240],plen=0;
  while(g++<8 && lora.ReceivePacketCommand(&id,&cmd,p,&plen,15)){
#if P2P
    if(cmd==P2P_CMD && plen>=9){ if(!joined) continue;   // tela inicial: ignora o radio (nao conectado)
      uint8_t fl=p[0]; world[1].active=true; world[1].fix=fl&1; world[1].alert=fl&2;
      world[1].lat=getLE32(p+1)/1e7; world[1].lon=getLE32(p+5)/1e7; world[1].lastMs=millis(); worldRxMs=millis(); continue; }
#endif
    handleRx(cmd,p,plen); } }

// ---- desenho ----
// detalhes de estilo por tema (grid/mira = fundo ; cantos = frente)
void chromeBg(){
  if(C_FL&FL_GRID){ for(int x=44;x<SCR_W;x+=46) gfx.drawFastVLine(x,26,SCR_H-26,C_LINE); for(int y=44;y<SCR_H;y+=46) gfx.drawFastHLine(0,y,SCR_W,C_LINE); }
  if(C_FL&FL_CROSS){ gfx.drawFastHLine(CXp-18,CYp,36,C_ROUTE); gfx.drawFastVLine(CXp,CYp-18,36,C_ROUTE); }
}
void chromeFg(){
  if(!(C_FL&FL_CORNERS)) return; int L=26,m=6; uint16_t c=C_ROUTE;
  gfx.drawFastHLine(m,m,L,c); gfx.drawFastVLine(m,m,L,c);
  gfx.drawFastHLine(SCR_W-m-L,m,L,c); gfx.drawFastVLine(SCR_W-m-1,m,L,c);
  gfx.drawFastHLine(m,SCR_H-m-1,L,c); gfx.drawFastVLine(m,SCR_H-m-L,L,c);
  gfx.drawFastHLine(SCR_W-m-L,SCR_H-m-1,L,c); gfx.drawFastVLine(SCR_W-m-1,SCR_H-m-L,L,c);
}
void triMarker(int cx,int cy,uint16_t col,int s){
  gfx.fillTriangle(cx,cy-s, cx-(int)(0.62f*s),cy+(int)(0.72f*s), cx+(int)(0.62f*s),cy+(int)(0.72f*s), col);
  gfx.fillTriangle(cx,cy-s, cx,cy+(int)(0.32f*s), cx+(int)(0.62f*s),cy+(int)(0.72f*s), col); // corpo cheio
}
void dotMarker(int cx,int cy,uint16_t col,int r){ gfx.fillCircle(cx,cy,r,col); gfx.drawCircle(cx,cy,r,C_WHITE); }
void roadSeg(int x0,int y0,int x1,int y1,uint16_t cas,uint16_t fil,int wc,int wf){
  for(int d=-(wc/2);d<=wc/2;d++){ gfx.drawLine(x0+d,y0,x1+d,y1,cas); gfx.drawLine(x0,y0+d,x1,y1+d,cas); }
  for(int d=-(wf/2);d<=wf/2;d++){ gfx.drawLine(x0+d,y0,x1+d,y1,fil); gfx.drawLine(x0,y0+d,x1,y1+d,fil); }
}
#define C_GHOST 0x7C53   // ponte tracejada onde o sinal caiu (nao deixa vao)
void drawDashed(int x0,int y0,int x1,int y1,uint16_t c){
  float dx=x1-x0,dy=y1-y0,len=sqrtf(dx*dx+dy*dy); if(len<1)return; dx/=len;dy/=len;
  for(float s=0;s<len;s+=16){ float e=fminf(s+8.0f,len);
    gfx.drawLine((int)(x0+dx*s),(int)(y0+dy*s),(int)(x0+dx*e),(int)(y0+dy*e),c);
    gfx.drawLine((int)(x0+dx*s),(int)(y0+dy*s)+1,(int)(x0+dx*e),(int)(y0+dy*e)+1,c); } }
void card(int x,int y,int w,int h){ gfx.fillRoundRect(x,y,w,h,7,C_CARD); gfx.drawRoundRect(x,y,w,h,7,C_LINE); }
// texto com fonte de verdade (y = base da linha). Depois volta pra fonte padrao.
void txt(const GFXfont*f,int x,int y,uint16_t col,const char*s){ gfx.setFont(f); gfx.setTextSize(1); gfx.setTextColor(col); gfx.setCursor(x,y); gfx.print(s); gfx.setFont(NULL); }
int txtW(const GFXfont*f,const char*s){ int16_t x1,y1; uint16_t w,h; gfx.setFont(f); gfx.setTextSize(1); gfx.getTextBounds(s,0,0,&x1,&y1,&w,&h); gfx.setFont(NULL); return w; }
void txtC(const GFXfont*f,int cx,int y,uint16_t col,const char*s){ txt(f,cx-txtW(f,s)/2,y,col,s); }
int nearestRouteIdx(double la,double lo){ int best=-1; double bd=1e18;
  for(int k=0;k<routeN;k++){ int idx=(routeHead-routeN+k+ROUTE_MAX)%ROUTE_MAX; double d=haversine(la,lo,route[idx].lat,route[idx].lon); if(d<bd){bd=d;best=k;} }
  return best; }

void drawMap(){
  gfx.fillScreen(C_BG); chromeBg();
  double clat=myLat,clon=myLon,chead=myHeading;
  if(!myFix){ gfx.setTextColor(C_AMBER); gfx.setTextSize(3); gfx.setCursor(30,CYp-20); gfx.print("PROCURANDO GPS..."); triMarker(CXp,CYp,C_BLUE,16); chromeFg(); return; }
  int myNear=nearestRouteIdx(clat,clon);
  double myBest=1e9; if(myNear>=0){ int mi=(routeHead-routeN+myNear+ROUTE_MAX)%ROUTE_MAX; myBest=haversine(clat,clon,route[mi].lat,route[mi].lon); }
  int psx=-1,psy=-1; double plat=0,plon=0; bool havePrev=false;
  for(int k=0;k<routeN;k++){ int idx=(routeHead-routeN+k+ROUTE_MAX)%ROUTE_MAX; int sx,sy; w2s(route[idx].lat,route[idx].lon,clat,clon,chead,sx,sy);
    bool vis=(sx>=-20&&sx<SCR_W+20&&sy>=-20&&sy<SCR_H+20);
    if(vis&&psx>=0){ bool gap=havePrev&&haversine(plat,plon,route[idx].lat,route[idx].lon)>40.0;
      if(!gap){ if(k>myNear) roadSeg(psx,psy,sx,sy,C_ROUTEC,C_ROUTE,10,5); else roadSeg(psx,psy,sx,sy,C_TRAVC,C_TRAV,8,3); }
      else drawDashed(psx,psy,sx,sy,C_GHOST); }   // vao (perda de sinal) -> ponte tracejada, nunca some
    psx=vis?sx:-1; psy=sy; plat=route[idx].lat; plon=route[idx].lon; havePrev=true;
  }
  // ALERTA: o caminho ENTRE o lider e o seguidor (o caminho de volta ate ele) fica VERMELHO se
  // QUALQUER um apertou (eu OU o seguidor). Assim o lider "vira seguidor" -> ve o trajeto ate ele.
  int peer=-1; for(int k=1;k<MAXN;k++) if(world[k].active&&millis()-world[k].lastMs<NODE_TTL){ peer=k; break; }
  bool alertOn = myAlert || (peer>=0 && world[peer].alert);
  if(alertOn && peer>=0){ int aN=nearestRouteIdx(world[peer].lat,world[peer].lon);
    if(aN>=0&&myNear>=0){ int a=min(aN,myNear),b=max(aN,myNear),qx=-1,qy=-1;
      for(int k=a;k<=b;k++){ int idx=(routeHead-routeN+k+ROUTE_MAX)%ROUTE_MAX; int sx,sy; w2s(route[idx].lat,route[idx].lon,clat,clon,chead,sx,sy);
        if(qx>=0) roadSeg(qx,qy,sx,sy,0x6800,C_RED,12,6); qx=sx; qy=sy; } } }
  int meSlot=joined?curSlot:255;
  // (o TRAJETO do lider e o proprio route[] desenhado acima; aqui so os marcadores)
  for(int k=0;k<MAXN;k++){ if(!world[k].active||k==meSlot) continue; if(millis()-world[k].lastMs>NODE_TTL) continue;
    int sx,sy; w2s(world[k].lat,world[k].lon,clat,clon,chead,sx,sy); if(sx<-30||sx>SCR_W+30||sy<-30||sy>SCR_H+30) continue;
    bool al=world[k].alert; uint16_t mc=al?C_RED:(k==0?C_AMBER:colorOf(world[k].color));
    if(k==0) triMarker(sx,sy,mc,15); else dotMarker(sx,sy,mc,9);
    gfx.setTextColor(mc); gfx.setTextSize(1); gfx.setCursor(sx+13,sy-5); gfx.print(haveRoster?rname[k]:(k==0?"Lider":"Carro")); }
  triMarker(CXp,CYp,C_BLUE,16);
  // FORA DE ROTA
  if(routeN>3 && myBest>OFFROUTE_M && ((millis()/350)%2==0)){
    for(int t=0;t<6;t++) gfx.drawRect(t,t,SCR_W-1-2*t,SCR_H-1-2*t,C_YEL);
    gfx.setTextColor(C_YEL); gfx.setTextSize(3); gfx.setCursor(CXp-110,20); gfx.print("FORA DE ROTA");
  }
  chromeFg();
  bool off=(worldRxMs==0||millis()-worldRxMs>LEAD_TTL);
  if(off){ card(SCR_W/2-110,8,220,30); gfx.setTextColor(C_RED); gfx.setTextSize(2); gfx.setCursor(SCR_W/2-90,16); gfx.print("LIDER OFFLINE"); }
}
void drawUI(){
  char b[32];
  card(10,10,200,54); gfx.fillCircle(30,37,6,C_BLUE);
  gfx.setTextColor(C_WHITE); gfx.setTextSize(2); gfx.setCursor(46,20); snprintf(b,sizeof(b),"Sala %lu",(unsigned long)room); gfx.print(b);
  gfx.setTextColor(C_MUT); gfx.setTextSize(1); gfx.setCursor(46,44); gfx.print(leaderRole?"voce e o LIDER":(joined?"seguidor":"entrando..."));
  // roster
  int rw=190, rx=SCR_W-rw-4, ry=10, rh=30;
  for(int k=0;k<MAXN;k++){ if(!world[k].active||millis()-world[k].lastMs>NODE_TTL) continue; card(rx,ry,rw,rh);
    bool me=(joined&&k==(int)curSlot), ld=(k==0); uint16_t col=me?C_BLUE:(ld?C_AMBER:colorOf(world[k].color));
    int icx=rx+20, icy=ry+rh/2;
    if(me||ld) gfx.fillTriangle(icx,icy-11,icx-10,icy+9,icx+10,icy+9,col); else gfx.fillCircle(icx,icy,9,col);
    gfx.setTextColor(world[k].alert?C_RED:C_WHITE); gfx.setTextSize(1); gfx.setCursor(rx+40,ry+rh/2-4);
    gfx.print(haveRoster?rname[k]:(ld?"Lider":"Carro"));
    if(!me && myFix && world[k].fix){ double d=haversine(myLat,myLon,world[k].lat,world[k].lon); char ds[10]; if(d>=1000)snprintf(ds,sizeof(ds),"%.1fk",d/1000.0); else snprintf(ds,sizeof(ds),"%dm",(int)d);
      gfx.setTextColor(C_MUT); gfx.setCursor(rx+rw-8-(int)strlen(ds)*6,ry+rh/2-4); gfx.print(ds); }
    ry+=rh+4; if(ry>SCR_H-96) break; }
  // distancia ao lider
  int cardY=SCR_H-92, cardH=82;
  if(leaderRole){
    // distancia ate o SEGUIDOR mais proximo (o carro de tras)
    double dmin=-1; for(int k=1;k<MAXN;k++) if(world[k].active&&world[k].fix&&millis()-world[k].lastMs<NODE_TTL){ double d=haversine(myLat,myLon,world[k].lat,world[k].lon); if(dmin<0||d<dmin)dmin=d; }
    card(10,cardY,214,cardH);
    gfx.setTextColor(C_MUT); gfx.setTextSize(1); gfx.setCursor(24,cardY+12); gfx.print("SEGUIDOR ATRAS");
    gfx.setTextColor(C_WHITE); gfx.setTextSize(6); gfx.setCursor(20,cardY+26);
    if(dmin<0){ gfx.print("--"); }
    else { if(dmin>=1000)snprintf(b,sizeof(b),"%.1fk",dmin/1000.0); else snprintf(b,sizeof(b),"%d",(int)dmin); gfx.print(b);
      gfx.setTextColor(C_MUT); gfx.setTextSize(2); gfx.setCursor(24+(int)strlen(b)*36+8,cardY+44); gfx.print(dmin>=1000?"km":"m"); }
    gfx.setTextColor(C_MUT); gfx.setTextSize(1); gfx.setCursor(24,cardY+cardH-14); snprintf(b,sizeof(b),"voce: %d km/h",(int)(mySpeed+0.5)); gfx.print(b); }
  else if(world[0].active && myFix){ double d=haversine(myLat,myLon,world[0].lat,world[0].lon);
    card(10,cardY,214,cardH);
    gfx.setTextColor(C_MUT); gfx.setTextSize(1); gfx.setCursor(24,cardY+12); gfx.print("DIST AO LIDER");
    gfx.setTextColor(C_WHITE); gfx.setTextSize(6); gfx.setCursor(20,cardY+26);
    if(d>=1000) snprintf(b,sizeof(b),"%.1fk",d/1000.0); else snprintf(b,sizeof(b),"%d",(int)d); gfx.print(b);
    gfx.setTextColor(C_MUT); gfx.setTextSize(2); gfx.setCursor(24+(int)strlen(b)*36+8,cardY+44); gfx.print(d>=1000?"km":"m");
    gfx.setTextColor(C_MUT); gfx.setTextSize(1); gfx.setCursor(24,cardY+cardH-14); snprintf(b,sizeof(b),"voce: %d km/h",(int)(mySpeed+0.5)); gfx.print(b); }
  // FAB alerta (toggle: fica aceso ate desligar)
  bool on=myAlert;
  gfx.fillCircle(abX,abY,abR, on?C_RED:C_CARD); gfx.drawCircle(abX,abY,abR,C_RED);
  uint16_t tc=on?C_WHITE:C_RED; gfx.fillTriangle(abX,abY-16,abX-16,abY+13,abX+16,abY+13,tc);
  gfx.fillRect(abX-2,abY-6,4,11,on?C_RED:C_CARD); gfx.fillRect(abX-2,abY+8,4,4,on?C_RED:C_CARD);
  // botoes de ZOOM (+ / -) empilhados acima do FAB alerta
  zSz=54; zpX=SCR_W-zSz-14; zpY=abY-abR-14-zSz; zmX=zpX; zmY=zpY-8-zSz;   // zmY = "+" (em cima), zpY = "-" (embaixo)
  gfx.fillRoundRect(zmX,zmY,zSz,zSz,10,C_CARD); gfx.drawRoundRect(zmX,zmY,zSz,zSz,10,C_LINE);
  gfx.fillRect(zmX+14,zmY+zSz/2-3,zSz-28,6,C_WHITE); gfx.fillRect(zmX+zSz/2-3,zmY+14,6,zSz-28,C_WHITE);  // "+"
  gfx.fillRoundRect(zpX,zpY,zSz,zSz,10,C_CARD); gfx.drawRoundRect(zpX,zpY,zSz,zSz,10,C_LINE);
  gfx.fillRect(zpX+14,zpY+zSz/2-3,zSz-28,6,C_WHITE);  // "-"
}
// ---- editar o nome do aparelho (engrenagem) ----
void gearRect(int&x,int&y,int&w,int&h){ w=320; h=60; x=SCR_W-w; y=4; }
void gearIcon(int cx,int cy,int r,uint16_t col){ for(int a=0;a<360;a+=45){ float rad=a*3.14159f/180.0f; gfx.fillCircle(cx+(int)(cos(rad)*r),cy+(int)(sin(rad)*r),3,col);} gfx.fillCircle(cx,cy,r,col); gfx.fillCircle(cx,cy,r/2,C_BG); }
void kbRect(int i,int&x,int&y,int&w,int&h){ int cols=7,kx=16,ky=140,kw=(SCR_W-32)/cols,kh=(SCR_H-ky-16)/4,r=i/cols,c=i%cols; x=kx+c*kw+4;y=ky+r*kh+4;w=kw-8;h=kh-8; }
void themeBtnRect(int i,int&x,int&y,int&w,int&h){ int bw=(SCR_W-32)/3; x=16+i*bw+2; y=100; w=bw-4; h=32; }
void drawNameEdit(){
  gfx.fillScreen(C_BG);
  txt(&FreeSans12pt7b,20,30,C_MUT,"Configuracoes do aparelho");
  gfx.drawRoundRect(16,40,SCR_W-32,50,10,C_ROUTE); gfx.drawRoundRect(17,41,SCR_W-34,48,10,C_ROUTE);
  txt(&FreeSansBold24pt7b,30,78,C_WHITE, nameBuf[0]?nameBuf:"...");
  for(int i=0;i<3;i++){ int x,y,w,h; themeBtnRect(i,x,y,w,h); bool sel=(i==themeIdx);
    gfx.fillRoundRect(x,y,w,h,8, sel?THEMES[i].route:C_CARD); gfx.drawRoundRect(x,y,w,h,8, sel?THEMES[i].route:C_LINE);
    txtC(&FreeSansBold12pt7b,x+w/2,y+h/2+5, sel?THEMES[i].bg:C_WHITE, THEMES[i].name); }
  for(int i=0;i<28;i++){ int x,y,w,h; kbRect(i,x,y,w,h); gfx.fillRoundRect(x,y,w,h,8,C_CARD); gfx.drawRoundRect(x,y,w,h,8,C_LINE);
    char lb[3]; uint16_t col=C_WHITE; if(i<26){lb[0]='A'+i;lb[1]=0;} else if(i==26){strcpy(lb,"<");col=C_RED;} else {strcpy(lb,"OK");col=C_ROUTE;}
    txtC(&FreeSansBold18pt7b,x+w/2,y+h/2+7,col,lb); }
}
void nameEditTouch(int tx,int ty){
  for(int i=0;i<3;i++){ int x,y,w,h; themeBtnRect(i,x,y,w,h); if(tx>=x&&tx<=x+w&&ty>=y&&ty<=y+h){ applyTheme(i); saveTheme(); return; } }
  for(int i=0;i<28;i++){ int x,y,w,h; kbRect(i,x,y,w,h);
    if(tx>=x&&tx<=x+w&&ty>=y&&ty<=y+h){ int L=strlen(nameBuf);
      if(i<26){ if(L<12){ nameBuf[L]='A'+i; nameBuf[L+1]=0; } }
      else if(i==26){ if(L>0) nameBuf[L-1]=0; }
      else { if(L>0){ strncpy(myName,nameBuf,15); myName[15]=0; saveName(); } editName=false; }
      return; }
  }
}
// ---- tela inicial: escolher o papel DESTA saida ----
void homeRects(int&bx,int&bw,int&bh,int&by1,int&by2){ bw=SCR_W-80; bx=40; bh=132; by1=168; by2=by1+bh+22; }
void drawHome(){
  gfx.fillScreen(C_BG);
  txt(&FreeSansBold24pt7b,40,78,C_WHITE,"TRILHA");
  txt(&FreeSans12pt7b,42,112,C_MUT,"Escolha o papel para esta saida");
  // nome do aparelho (esquerda) + engrenagem maior (canto sup direito)
  int gcx=SCR_W-40, gcy=42; gearIcon(gcx,gcy,17,C_MUT);
  int nw=txtW(&FreeSansBold12pt7b,myName); txt(&FreeSansBold12pt7b,gcx-32-nw,gcy+6,C_WHITE,myName);
  int bx,bw,bh,by1,by2; homeRects(bx,bw,bh,by1,by2);
  gfx.fillRoundRect(bx,by1,bw,bh,16,C_ROUTE);
  txt(&FreeSansBold24pt7b,bx+40,by1+bh/2+12,C_BG,"CRIAR SALA");
  gfx.drawRoundRect(bx,by2,bw,bh,16,C_BLUE); gfx.drawRoundRect(bx+1,by2+1,bw-2,bh-2,16,C_BLUE); gfx.drawRoundRect(bx+2,by2+2,bw-4,bh-4,16,C_BLUE);
  txt(&FreeSansBold24pt7b,bx+40,by2+bh/2+12,C_BLUE,"ENTRAR NA SALA");
}
#if P2P
// pareamento 1:1 do GIGA (lider fixo do par GIGA<->WS)
void gigaP2pPair(){ leaderRole=true; room=1; joined=true; curSlot=0; uiPage=0; searching=false;
  ruid[0]=myUid; strncpy(rname[0],myName,15); rname[0][15]=0; rcolor[0]=myColor;
  strncpy(rname[1],"Waveshare",15); rname[1][15]=0; haveRoster=true; }
#endif
void homeTouch(int tx,int ty){
  int gx,gy,gw,gh; gearRect(gx,gy,gw,gh);
  if(tx>=gx&&tx<=gx+gw&&ty>=gy&&ty<=gy+gh){ editName=true; strncpy(nameBuf,myName,15); nameBuf[15]=0; if(!strcmp(nameBuf,"Carro"))nameBuf[0]=0; return; }
  int bx,bw,bh,by1,by2; homeRects(bx,bw,bh,by1,by2);
  if(tx>=bx&&tx<=bx+bw){ bool b1=(ty>=by1&&ty<=by1+bh),b2=(ty>=by2&&ty<=by2+bh);
#if P2P
    if(b1||b2) gigaP2pPair();   // 1:1: qualquer botao conecta (GIGA=lider fixo)
#else
    if(b1){ pendingRole=1; uiPage=1; codeLen=0; codeBuf[0]=0; }
    else if(b2){ pendingRole=0; uiPage=1; codeLen=0; codeBuf[0]=0; }
#endif
  } }
// ---- teclado do codigo da sala ----
static const char* KPLAB[12]={"1","2","3","4","5","6","7","8","9","<","0","OK"};
void kpRect(int i,int&x,int&y,int&w,int&h){
  int kpW=(int)(SCR_W*0.6),kpX=(SCR_W-kpW)/2,kpTop=(int)(SCR_H*0.30);
  int kw=kpW/3, kh=(SCR_H-kpTop-10)/4, r=i/3,c=i%3; x=kpX+c*kw+4; y=kpTop+r*kh+4; w=kw-8; h=kh-8;
}
void drawKeypad(){
  gfx.fillScreen(C_BG);
  txt(&FreeSans12pt7b,24,34,C_MUT, pendingRole==1?"Criar sala - digite o codigo":"Entrar - digite o codigo da sala");
  int bw=66, gap=14, bx=(SCR_W-(bw*5+gap*4))/2, by=52;
  for(int i=0;i<5;i++){ int x=bx+i*(bw+gap); gfx.drawRoundRect(x,by,bw,bw,10,i<codeLen?C_ROUTE:C_LINE);
    if(i<codeLen){ char c[2]={codeBuf[i],0}; txtC(&FreeSansBold24pt7b,x+bw/2,by+bw/2+13,C_WHITE,c); } }
  for(int i=0;i<12;i++){ int x,y,w,h; kpRect(i,x,y,w,h); gfx.fillRoundRect(x,y,w,h,10,C_CARD); gfx.drawRoundRect(x,y,w,h,10,C_LINE);
    uint16_t c=(i==9)?C_RED:(i==11?C_ROUTE:C_WHITE); txtC(&FreeSansBold18pt7b,x+w/2,y+h/2+8,c,KPLAB[i]); }
}
void keypadTouch(int tx,int ty){
  for(int i=0;i<12;i++){ int x,y,w,h; kpRect(i,x,y,w,h);
    if(tx>=x&&tx<=x+w&&ty>=y&&ty<=y+h){
      if(i==9){ if(codeLen>0) codeBuf[--codeLen]=0; else uiPage=0; }
      else if(i==11){ if(codeLen==5){ room=atol(codeBuf); if(room==0)room=1; leaderRole=(pendingRole==1);
        if(leaderRole){ curSlot=0; joined=true; ruid[0]=myUid; strncpy(rname[0],myName,15); rname[0][15]=0; rcolor[0]=myColor; haveRoster=true; searching=false; }
        else { joined=false; curSlot=0; searching=true; worldRxMs=0; } } }
      else if(codeLen<5){ codeBuf[codeLen++]=KPLAB[i][0]; codeBuf[codeLen]=0; }
      return;
    }
  }
}
// tela de busca (seguidor procurando a sala)
void searchRects(int&x,int&y,int&w,int&h){ w=220; h=60; x=(SCR_W-w)/2; y=SCR_H-h-40; }
void drawSearching(){
  gfx.fillScreen(C_BG);
  char rm[10]; snprintf(rm,sizeof(rm),"%lu",(unsigned long)room);
  txtC(&FreeSans12pt7b, CXp, 130, C_MUT, "Procurando sala");
  txtC(&FreeSansBold24pt7b, CXp, 195, C_WHITE, rm);
  int nd=(millis()/450)%4; char aw[40]="aguardando o lider"; int L=strlen(aw); for(int i=0;i<nd&&L+i<38;i++)aw[L+i]='.'; aw[L+nd]=0;
  txtC(&FreeSans12pt7b, CXp, 245, C_MUT, aw);
  int x,y,w,h; searchRects(x,y,w,h); gfx.drawRoundRect(x,y,w,h,14,C_LINE); gfx.drawRoundRect(x+1,y+1,w-2,h-2,14,C_LINE);
  txtC(&FreeSansBold18pt7b, CXp, y+h/2+8, C_MUT, "VOLTAR");
}
void handleTouch(){
  GDTpoint_t p[5]; uint8_t n=touch.getTouchPoints(p);
  if(n>0){ int tx=p[0].y, ty=(SCR_H-1)-p[0].x;   // mapeamento original do GIGA
    if(!touchWasDown){
      if(room==0){ if(editName) nameEditTouch(tx,ty); else if(uiPage==0) homeTouch(tx,ty); else keypadTouch(tx,ty); }
      else if(searching){ int x,y,w,h; searchRects(x,y,w,h); if(tx>=x&&tx<=x+w&&ty>=y&&ty<=y+h){ room=0; searching=false; uiPage=0; joined=false; } }
      else if(tx>=zmX&&tx<=zmX+zSz&&ty>=zmY&&ty<=zmY+zSz){ mapMPP*=0.7f; if(mapMPP<0.5f)mapMPP=0.5f; }   // + : aproxima
      else if(tx>=zpX&&tx<=zpX+zSz&&ty>=zpY&&ty<=zpY+zSz){ mapMPP*=1.4f; if(mapMPP>40.0f)mapMPP=40.0f; }   // - : afasta
      else if((tx-abX)*(tx-abX)+(ty-abY)*(ty-abY) <= (abR+8)*(abR+8)) myAlert=!myAlert;   // liga/desliga
    }
    touchWasDown=true; } else touchWasDown=false;
}

void setup(){
  Serial.begin(115200); Serial1.begin(9600); Serial2.begin(9600); delay(150);
  lora.begin(false); lora.localread(); myUid=lora.localUniqueId;
  lora.config_bps(BW500, SF_LoRa_7, CR4_5);   // TRAVA o canal RF (2/7/1). Os DOIS lados usam os MESMOS valores -> nunca desalinha.
  loadName(); loadTheme(); applyTheme(themeIdx);
  gfx.begin(); gfx.setRotation(1);
  SCR_W=gfx.width(); SCR_H=gfx.height(); CXp=SCR_W/2; CYp=SCR_H/2;
  abR=40; abX=SCR_W-abR-14; abY=SCR_H-abR-14;
  touch.begin();
  for(int k=0;k<MAXN;k++){ world[k]=Node(); world[k].color=k; snprintf(rname[k],16,k==0?"Lider":"Carro %d",k); rcolor[k]=k; ruid[k]=0; }
#if P2P
  room=0; uiPage=0; leaderRole=false; joined=false; searching=false; myAlert=false;   // 1:1: comeca na TELA INICIAL; conecta ao apertar um botao
  strncpy(rname[1],"Waveshare",15); rname[1][15]=0;
#endif
  gfx.startBuffering(); gfx.fillScreen(C_BG); gfx.endBuffering();
  Serial.print("== GRUPO GIGA (seguidor) == sala="); Serial.print(room); Serial.print(" slot="); Serial.println(mySlot);
}
void loop(){
  handleSerial(); readGPS(); readLoRa(); handleTouch();
#if BANCADA
  // GIGA (lider) fake ANDA: gera trajeto visivel na bancada (WS parada ve o rastro do lider crescer)
  { static double bLat=-23.5499, bLon=-46.6300; static unsigned long bt=0;
    if(millis()-bt>400){ bt=millis(); bLat+=0.00002; bLon+=0.000013*sin(millis()/4000.0); }
    myLat=bLat; myLon=bLon; myHeading=0; myFix=true; mySats=9; }
#endif
  unsigned long now=millis();
  if(leaderRole||joined){ int msi=leaderRole?0:curSlot; world[msi].active=true; world[msi].fix=myFix; world[msi].alert=myAlert;
    world[msi].lat=myLat; world[msi].lon=myLon; world[msi].lastMs=now; }
#if P2P
  // LIDER: grava o proprio caminho e manda posicao + TRAJETO pro seguidor (unicast, sem flooding).
  // so transmite quando CONECTADO (joined). Na tela inicial o radio fica QUIETO -> reset = comeca limpo.
  if(joined) leaderRecordOwnPath();
  static unsigned long lp=0; if(joined && now-lp>1000){ sendTrail(); lp=now; } else if(!joined) worldRxMs=0;
#else
  if(room!=0){
    if(leaderRole){ leaderRecordOwnPath(); static uint8_t cyc=0; if(now-lastCycle>=CYCLE_MS){ if(myFix){ sendWorld(); if((cyc++%3)==0) sendRoster(); } lastCycle=now; } }
    else if(!joined){ static unsigned long lj=0; if(now-lj>1500){ sendJoin(); lj=now; } }
    else if(pendingUplink && now>=slotDue){ sendUplink(); pendingUplink=false; }
  }
#endif
  if(now-lastDraw>250){ gfx.startBuffering(); if(room==0){ if(editName) drawNameEdit(); else if(uiPage==0) drawHome(); else drawKeypad(); } else if(searching) drawSearching(); else { drawMap(); drawUI(); } gfx.endBuffering(); lastDraw=now; }
  if(now-lastDbg>2000){ int c=0; for(int k=0;k<MAXN;k++) if(world[k].active&&now-world[k].lastMs<NODE_TTL)c++;
    Serial.print("GIGA | LoRa uid="); Serial.print(myUid); Serial.print(myUid>0?"(OK)":"(SEM RESPOSTA!)");
    Serial.print(" | GPS fix="); Serial.print(myFix?"S":"N"); Serial.print(" sat="); Serial.print(mySats);
    Serial.print(" | world="); Serial.print(worldRxMs?"ok":"--"); Serial.print(" nos="); Serial.println(c); lastDbg=now; }
}
