gabrielDallape/minhoca-trail-system/firmware/mts/app/rede.h

#pragma once
// ============================================================================
//  REDE - o no no ar: TDMA + protocolo + frota + rota, sobre o hal/radio.h
// ============================================================================
//
// Aqui se decide QUANDO falar (tdma_core), O QUE falar (posicao com cauda de
// trilha, ou roster), o que fazer com o que chegou (frota, rota, ancora de
// tempo) e o que escrever no diario (linhas R/T/N/V). O chip e problema do
// hal/radio.h; o carro e problema do core/frota.h.
//
// AS REGRAS QUE VIERAM DO CAMPO e que este arquivo carrega:
//
//   - A POTENCIA NUNCA MUDA SOZINHA (usuario, 2026-09-28 e 2026-09-29). Nao
//     existe recuo automatico, resgate de boot nem teto de "modo seguro". Apos
//     RADIO_SEGURO_APOS reinicios violentos seguidos (hal/caixa.h) o que acontece
//     e um ALARME: faixa vermelha na tela e linha no diario, com a potencia
//     intacta. Ate 2026-09-29 esse caso baixava para 2 dBm em RAM - e somado a
//     um boot-loop por radio mudo, terminava pior que os 6 dBm do campo.
//   - Um pacote de VERSAO diferente e ignorado, contado e AVISADO na tela.
//   - A primeira fala e sempre POSICAO (roster nao ancora ninguem); os rosters
//     de arranque sao INTERCALADOS (falas 1, 3, 5) para nunca haver dois quadros
//     seguidos sem beacon - com 6 s de quadro, dois quadros mudos passavam do
//     TTL de holdover de entao (12,5 s) e a rede se partia no arranque (I5).
//     Hoje o TTL e de 24,5 s (12 quadros de 2 s, core/tdma.h), mas a regra continua.
//   - O vigia de TX preso pergunta ao chip antes de acusar, espera mais que o
//     maior pacote (RADIO_VIGIA_MS), e refaz o begin() completo.
//   - O mapa e o cartao perguntam ao orcamento antes de gastar tempo; a
//     pergunta e respondida aqui (redePodeGastar).

#include <stdint.h>
#include <string.h>
#include "../core/params.h"
#include "../core/airtime.h"
#include "../core/proto.h"
#include "../core/tdma.h"
#include "../core/frota.h"
#include "../core/rota.h"
#include "../core/trajeto.h"
#include "../core/orcamento.h"
#include "../core/vizinhos.h"
#include "../hal/pinos.h"
#include "../hal/relogio.h"
#include "../hal/caixa.h"
#include "estado.h"
#include "registro.h"
#if MTS_TEM_RADIO
#include "../hal/radio.h"
#endif
#if MTS_TEM_GPS
#include "../hal/gps.h"
#endif
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
