gabrielDallape/minhoca-trail-system/(commit log)

2026-07-13 Overhaul das telas + mapa no lider + alerta bidirecional
    Seguidor (giga_follow):
    - fundo azul-mapa, seta EU com brilho, rota roxa (falta ir) + rastro ciano
    que desbota, aneis de distancia, zoom manual +/- (sem auto-zoom)
    - aviso FORA DE ROTA piscando (amarelo) quando sai do caminho do lider
    - ponte tracejada quando perde sinal alem do buffer (nem reta, nem vao)
    - botao de alerta (so o simbolo); recebe alerta do lider (borda piscando)
    Lider (cyd_lead):
    - passa a plotar o proprio mapa (EU no centro + caminho tracado, ciano
    que desbota), aneis, norte, barra de status fina no topo
    - buffer de historico 24 -> 26 pontos (~130m recuperavel, payload 213B)
    - botao de alerta redondo (FAB) usando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
2026-07-13 Plano de trabalho do Modo Grupo (sala de ate 8 carrinhos)
    Arquitetura, radio (beacon+slots), todas as telas, armazenamento (NVS),
    config por WiFi, 6 fases de implementacao testaveis e decisoes em aberto.
2026-07-13 Fase 1 do Modo Grupo: sketch de teste do radio (beacon + slots)
    Headless (so serial). Hub-and-spoke: lider (master ID0) faz broadcast do
    beacon (dest 2047); seguidores mandam uplink pro lider na sua vez (slot k
    = beaconRx + k*SLOT_MS). Valida rodizio sem colisao. Um arquivo, muda
    NODE_ID por aparelho. Compila em esp32 (CYD) e mbed_giga (GIGA).
2026-07-13 Modo Grupo: runtime unificado ESP32/LovyanGFX (lider ou seguidor)
    Um binario, papel/sala/slot/cor em NVS (config por serial na bancada).
    Protocolo hub: lider faz broadcast do estado do mundo (posicoes de todos +
    rota + alertas + cores); seguidores fazem uplink na sua vez (slot). Mapa
    profissional: voce = triangulo azul, lider = triangulo amarelo, outros =
    bolinhas na cor deles; estrada com contorno (a seguir teal / percorrido
    cinza), alerta = estrada vermelha seguindo o caminho ate quem apertou.
    Botao de alerta (so simbolo), lider offline = segura + aviso. Compila
    esp32 (33% flash). Falta: pagina de config WiFi no lider.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
2026-07-13 Modo Grupo: config pelo WiFi (pagina no celular)
    Cada aparelho sobe um AP 'Trilha-<nome>' + pagina web (sem app, funciona
    em iPhone) pra definir sala, papel (lider/seguidor), slot, nome e cor.
    Salva em NVS. Substitui a config por serial. Compila esp32 (83% flash no
    CYD; folgado na Waveshare 16MB).
2026-07-13 Modo Grupo: roster (nomes/cores) + config centralizada + calibracao toque
    - CMD_ROSTER 0x31: lider retransmite nome+cor de todos os slots; seguidores
    aplicam. Cores atribuidas tambem vao no WORLD.
    - Config CENTRALIZADA: pagina WiFi do lider edita nome+cor de cada carro
    (slots 1..7); salvo em NVS e transmitido.
    - Lista de carros (roster) no canto do mapa: forma+cor+nome de cada no.
    - setTouchCalibrate com os valores do CYD (XPT2046).
2026-07-13 Modo Grupo: seguidor no GIGA (reserva / bench-test com o CYD)
    Mesmo protocolo (WORLD/ROSTER/UPLINK), render em GigaDisplay_GFX paisagem:
    voce=triangulo azul, lider=triangulo amarelo, outros=bolinhas, estrada com
    contorno, alerta=estrada vermelha, roster lateral, distancia, FAB de alerta,
    LIDER OFFLINE. So seguidor; config por serial (R sala / F slot). Permite
    testar 2 nos hoje (CYD lider + GIGA seguidor). Compila mbed_giga (8% flash).
2026-07-13 Modo Grupo: fora-de-rota + etiquetas de nome no mapa
    - Aviso FORA DE ROTA (pisca amarelo) quando o seguidor se afasta >30m do
    caminho do lider (best ao ponto mais perto da rota).
    - Nome de cada no aparece ao lado do marcador no mapa (lider e bolinhas).
    Nos dois: grupo (CYD) e grupo_giga_follow (GIGA).
2026-07-13 Modo Grupo: teclado do codigo da sala na telinha + sair da sala
    - room 0 = nao configurado -> mostra teclado numerico na tela (toque) pra
    digitar o codigo de 5 digitos e entrar na sala (como seguidor).
    - Sair da sala: serial 'X', link '/leave' na pagina WiFi, volta pro teclado.
    - Nao transmite no radio enquanto nao tem sala.
    Nos dois sketches (CYD e GIGA).
2026-07-13 Modo Grupo: join automatico (seguidor entra e o lider atribui a vaga)
    - Cada aparelho usa o UID do modulo LoRa como identidade.
    - CMD_JOIN 0x33: seguidor manda uid+nome+cor; o lider acha/atribui a
    primeira vaga livre (1..7) e grava no roster (NVS).
    - ROSTER agora carrega o uid de cada slot; o seguidor acha a propria vaga
    pelo uid e passa a fazer uplink nela (curSlot). Antes de entrar, so manda
    JOIN (nao ocupa slot). Mapa/lista usam a vaga atribuida; "entrando..." ate
    entrar. Nos dois sketches (CYD + GIGA).
2026-07-13 Modo Grupo: tela inicial Criar/Entrar (papel escolhido por saida)
    Sem sala -> tela inicial com CRIAR SALA (vira lider agora) e ENTRAR NA SALA
    (vira seguidor agora); o teclado do codigo vem depois e aplica o papel
    escolhido. Papel NAO e fixo do aparelho: sair da sala volta pro inicio e
    pode escolher outro papel na proxima. Pagina WiFi tambem passou a listar
    'conectados agora' (nome+cor). Compila esp32 (84% flash).
    [grupo.ino]
2026-07-13 Modo Grupo: GIGA vira PEER COMPLETO (lider OU seguidor)
    Removida a limitacao 'so seguidor' do GIGA. Agora tem a mesma tela inicial
    Criar/Entrar, logica de lider (broadcast do mundo + roster + join + rota
    propria) e de seguidor. Papel escolhido por saida, igual ao grupo.ino do
    ESP32. Compila mbed_giga (8% flash).
2026-07-13 Modo Grupo: alerta vira liga/desliga (toggle), sem timer
    Aperta uma vez -> alerta ON (sua posicao fica marcada pros outros); aperta
    de novo -> OFF. Antes era timer de ~5s. Vale nos dois sketches (CYD + GIGA).
    FAB fica aceso enquanto o alerta esta ligado.
2026-07-13 Modo Grupo: fonte de verdade + fix texto gigante + Procurando sala
    GIGA (grupo_giga_follow):
    - fontes FreeSans/FreeSansBold na tela inicial e no teclado (menos amador);
    helper txt()/txtC() fixando setTextSize(1) -> corrige o bug de texto
    GIGANTE ao voltar do teclado. Removida a faixa verde do topo.
    - Tela "Procurando sala": ao ENTRAR, o seguidor mostra "procurando..." e so
    entra quando OUVE o lider daquela sala; botao VOLTAR. Nao entra em sala
    inexistente.
    CYD (grupo): mesma logica de "Procurando sala" + botao Voltar.
    [grupo.ino, grupo_giga_follow.ino]
2026-07-13 Modo Grupo (GIGA): nome do aparelho editavel (engrenagem) + salvo na flash
    Tela inicial ganha botao de engrenagem com o nome do aparelho. Toca ->
    teclado de letras (A-Z) pra digitar o nome (ex.: Sergio); salvo na memoria
    persistente do GIGA (mbed kvstore) e usado no roster/uplink no lugar de
    "Carro". Sobrevive a desligar.
2026-07-13 Modo Grupo (GIGA): icone do roster um pouco maior e mais a direita
    Ajuste fino pedido: marcadores da lista de carrinhos (roster) maiores
    (bolinha r7, triangulo maior) e a lista um pouco mais colada na direita.
2026-07-13 Modo Grupo (GIGA): velocidade do lider + distancia por carro no roster
    - Card do lider mostra VELOCIDADE (km/h). Seguidor mostra dist ao lider +
    a propria velocidade.
    - Cada linha do roster mostra a distancia daquele carro (do meu ponto ao
    dele) -> o lider ve a distancia dos carros de tras. Icones um pouco maiores.
2026-07-13 Modo Grupo (GIGA): seletor de tema (Rally/Tatico/HUD) na engrenagem
    Cores viraram tema variavel (applyTheme) -> zero custo de runtime. 3 temas:
    RALLY (ambar), TATICO (verde-oliva), HUD (ciano/minimal). Seletor na tela
    de configuracoes (engrenagem), salvo na flash por aparelho (kvstore).
2026-07-13 Modo Grupo (GIGA): detalhes de estilo por tema (cantos/grid/mira)
    Flags por tema: RALLY = cantos de HUD; TATICO = grid + mira central;
    HUD = limpo. Desenhados no mapa (chromeBg/chromeFg) conforme o tema.
2026-07-13 Nucleo compartilhado (trilha_core.h) + CYD reescrito em cima dele
    trilha_core.h = "codigo padrao" de todo aparelho: protocolo LoRa (pack/parse),
    estado do grupo, temas (Rally/Tatico/HUD), regras. Sem hardware.
    grupo/ (CYD, LovyanGFX) vira uma casca fina: so tela/toque/LoRa/GPS/NVS +
    desenho, chamando o nucleo. Todas as telas portadas p/ 320x240 com fontes,
    engrenagem (nome+tema), teclados, procurando sala, mapa/roster/velocidade,
    alerta toggle, chrome por tema. Compila esp32 35% flash (config on-device
    substituiu a pagina WiFi -> mais leve). GIGA segue intacto/funcionando.
2026-07-26 Ferramentas de bring-up/diagnóstico da Waveshare 7B
    Sketches usados para trazer a tela Waveshare ESP32-S3-Touch-LCD-7B à vida
    e depurar cada subsistema durante o desenvolvimento:
    - ws_diag / ws_hello / ws_quiet / ws_lcd_oficial: painel RGB, backlight, sprite
    - ws_touch_diag: GT911 (varre I2C, confirma endereço 0x5D, lê Product ID "911")
    - ws_lora_scan: descobre os pinos do header UART2 (LoRa) -> GPIO 44/43
    - ws_lora_cfg: lê a config completa do módulo LoRaMESH (não-destrutivo)
    - ws_lora_align: alinha o rádio ao canal do par (BW500/SF7/CR4_5)
    - ws_lora_commission: comissiona um módulo LoRa novo na rede
    - giga_lora_cfg: lê a config do módulo LoRa do GIGA (13680)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
2026-07-26 grupo_ws: firmware das 2 telas Waveshare (líder + seguidor)
    Firmware único para as duas telas Waveshare 7B; o papel é escolhido por
    toque na tela inicial (CRIAR SALA = líder, ENTRAR = seguidor). Substitui a
    fase GIGA (LoRa do GIGA falhou).
    Protocolo P2P (ponto-a-ponto, sem broadcast):
    - 0x11 seguidor->líder: posição + flags + lastSeq (ACK p/ catch-up)
    - 0x12 líder->seguidor: posição + bloco do trajeto a partir de seqBase;
    em catch-up reenvia do ACK+1 em blocos (acelera p/ ~3 Hz) até alcançar.
    - seguidor só aceita pontos contíguos, ou salto quando flag de catch-up.
    Navegação/UI:
    - caminho roxo (a percorrer) / azul (já percorrido), cores fixas por tema
    - trajeto real (brea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
    [LGFX_WS7B.h, grupo_ws.ino, trilha_core.h]
2026-07-26 Atualiza README p/ arquitetura de 2 telas Waveshare + GIGA (referência)
    README reescrito: descreve a versão atual (duas Waveshare rodando grupo_ws),
    funcionalidades, protocolo P2P (0x11/0x12), fluxo gravar-vs-usar (USB nativo
    vs UART1+switch UART2), dicas de GPS (LED, céu aberto) e build.
    grupo_giga_follow: paridade de features com o grupo_ws (trajeto, alerta no
    caminho, distância) — mantido como referência da fase GIGA (descontinuada).
2026-07-26 Reorganiza repositório + LICENSE/CHANGELOG + README profissional
    Estrutura: firmware/ (em uso) · tools/ (diagnóstico Waveshare) ·
    legacy/ (fases antigas) · docs/ (planos). Move os 53 sketches para os
    grupos correspondentes com git mv (histórico preservado).
    - firmware/: grupo_ws + trilha_core.h (compila no novo local; ../trilha_core.h ok)
    - legacy/grupo: include ajustado para ../../firmware/trilha_core.h
    - README: badges, diagrama de arquitetura ASCII, árvore de estrutura, paths de build atualizados
    - LICENSE (MIT) e CHANGELOG.md (3 fases do projeto)
2026-07-27 Plano de implementação da rede TDMA-LoRa (25-50 nós)
    Consolida a pesquisa técnica de implementação em um guia de construção:
    - Plataforma ESP-IDF v5.3+ (P4), reaproveitando trilha_core.h (migra ~intacto)
    - Rádio RadioLib + E22-900M30S: config + 3 armadilhas resolvidas
    (setRfSwitchPins TXEN/RXEN, setCurrentLimit 140mA, TCXO 1.8V no begin)
    - TDMA por GPS-PPS: método do race tracker + código de referência + holdover
    - Rede plana 1-salto broadcast; pacote de posição de 16 bytes
    - Estrutura de tasks (LoRa/TDMA/GPS no core 1, LVGL no core 0)
    - 8 fases de implementação (bring-up → LoRa cru → TDMA → PPS → GPS → mapa → alerta → escala)
    - Riscos honestos + fontes (códi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
2026-07-27 Plano: adiciona seção de mapa offline (preparação + renderização)
    - Preparação: baixar tiles (MOBAC + Thunderforest, não OSM direto), converter
    PNG→bin RGB565 com script do map_tiles, gravar no SD; z13-16, ~200MB/trilha,
    dezenas de trilhas cabem no SD 64GB; cliente final recebe SD pré-carregado
    - Renderização: componente map_tiles (0015, MIT, LVGL9) roda no P4; grid de
    lv_image rolável, carros como overlay, grid 3x3 em PSRAM
    - Reaproveitar o exemplo 02.ESP32-S3_Map_LoRa_GPS (quase o esqueleto: mapa+GPS+LoRa)
    - Decisão: NORTH-UP (não heading-up: girar mapa é pesado no P4), gira só o ícone
    - Falta escrever: rastro + anéis (canvas/line, reusa worldToScreen/haversine)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
2026-07-30 Fase 4: camada TDMA + pipeline de mapa offline (sem tocar no grupo_ws)
    Prepara a pilha nova em sketches separados. O firmware em producao
    (firmware/grupo_ws, LoRaMESH) nao foi alterado.
    Ambiente de build (estava quebrado, nada compilava):
    - core esp32:esp32 nao estava instalado; faltavam LovyanGFX, TinyGPSPlus e
    LoRaMESH. Agora em esp32 3.3.11 + RadioLib 7.6.0.
    - tools/build.ps1 encapsula o caminho do arduino-cli (vive dentro da Arduino
    IDE, fora do PATH) e o FQBN das duas placas; reporta o tamanho do binario.
    - docs/AMBIENTE_BUILD.md registra as versoes exatas.
    - grupo_ws medido pela 1a vez: 449 KB, 14% dos 3 MB de huge_app. Um esquema
    com dois slots (OTA) caberia com folga de 4x, se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
2026-07-30 sd_bench: mede CS pelo expansor, custo de leitura e contencao do painel
    Bench para as tres perguntas que travam a arquitetura de render do mapa e nao
    tem resposta em documentacao:
    1) O CS do cartao esta no expansor I2C (EXIO4 do CH32V003, io_extension.h:46),
    nao num GPIO - nenhuma lib de SD espera isso. O cartao exige CS ALTO durante
    os primeiros ~74 clocks, entao "prender em baixo" pode quebrar a
    inicializacao. O bench tenta duas estrategias (CS alto + 96 clocks dummy e
    depois baixo; ou baixo desde o inicio) e reporta qual funcionou. Tambem mede
    o custo de uma troca de CS por I2C, que e o motivo de nao dar para comutar
    por transacao SPI.
    2) Custo real de ler 1 setor, 1 t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
2026-07-30 docs/RETOMAR.md: ponto de entrada para quando o hardware chegar
    Reune o que precisaria ser reconstruido de memoria numa proxima sessao:
    - os tres sketches que rodam HOJE nas telas existentes (dois selftests + o
    sd_bench), com os comandos prontos
    - pinagem do E22 no devkit e as tres coisas que queimam ou frustram antes de
    energizar (antena, 5V com capacitor de bulk, antena do radio longe do GNSS)
    - por que o E22 nao cabe nas telas: o painel RGB come 20 dos 45 GPIOs e o radio
    precisa de 8 (nao usar setDio2AsRfSwitch - o PA precisa de RXEN/TXEN)
    - o que medir em cada fase e o que cada contador do tdma_test significa
    - a receita do erro -707 (TCXO 1.8 -> 1.6 -> XTAL=true)
    - que o PPS do N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
2026-07-30 CLAUDE.md + README/RETOMAR: contexto completo para retomar sem memoria
    Deixa o repo auto-explicativo para uma sessao nova (humana ou agente).
    CLAUDE.md (lido automaticamente pelo Claude Code ao abrir o projeto):
    - o que o projeto e, e a distincao critica entre as DUAS coisas em paralelo:
    firmware/grupo_ws (producao, LoRaMESH, validado) x Fase 4 (TDMA + mapa, em
    construcao). Regra dura: nao alterar o grupo_ws sem pedido explicito.
    - tabela do que esta validado x do que so compila
    - hardware em maos x em transito
    - como compilar (o arduino-cli nao esta no PATH)
    - as armadilhas que ja custaram tempo, com fonte: LoRaMESH incompativel com
    TDMA, config_bps mentindo no retorno, escravo trans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
2026-08-01 Bancada web: simulador das 4 telas + auditor contra o firmware
    Simulador das telas embarcadas em canvas 1024x600, no ar em
    bancada-trilha.vercel.app. Reexecuta a logica do firmware em tres modos:
    GRUPO #define P2P 0 - codigo de 5 digitos, JOIN/ROSTER por slot,
    WORLD em broadcast, 4 telas
    P2P #define P2P 1 (o que esta gravado hoje) - par fixo, TRAIL com
    catch-up por ack
    TDMA tdma_core.h + tdma_test.ino - rede plana, pacote de 16 B,
    SX1262 cru, clock proprio por no (offset + drift de +-40 ppm)
    O desenho e transcricao linha a linha de drawHome/drawKeypad/drawSettings/
    drawSearching/drawMap/drawUI sobre um shim da API LovyanGFX; a matematica e o
    protocolo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
2026-08-01 tdma_core: corrige 4 bugs achados na bancada (1 calava metade da rede)
    Nenhum precisou de radio para aparecer. Codigo da Fase 4, nunca executado.
    1. frameBase calava metade da rede (o grave)
    frameBase += (rxUs - anchorUs) / frameUs era divisao INTEIRA. Num no com
    cristal mais lento que o da ancora, o intervalo entre beacons medido no
    relogio local fica abaixo de frameUs (1 s a -40 ppm = 999,96 ms), o resultado
    dava 0, o frameBase congelava e a guarda de "1 TX por frame" travava o no PARA
    SEMPRE - exatamente o sintoma que este campo existe para evitar.
    Medido na bancada, 60 s, cristais forcados:
    0 / -30 / -20 / -10 ppm -> tx = 60 / 2 / 2 / 2 (truncando)
    0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
    [tdma_core.h, tdma_test.ino]
2026-08-01 grupo_ws: SALA -> GRUPO + 6 correcoes de logica (a pedido do usuario)
    Mexer aqui foi decisao explicita do usuario - o CLAUDE.md pede que nao se toque no
    firmware validado em campo sem pedido. Compila em 449331 B (14 % de huge_app),
    +204 B. NADA foi gravado nem testado em campo.
    Vocabulario: CRIAR GRUPO / ENTRAR NO GRUPO / GRUPO 12345 / SAIR DO GRUPO /
    PROCURANDO GRUPO, e "grupo=" no serial. A chave NVS segue "room": nenhuma tela
    perde configuracao ao regravar.
    Correcoes, todas encontradas na bancada web e reproduzidas com radio ideal (isto
    e: nao dependem de nenhuma hipotese sobre o radio):
    1. Carro zumbi. Nada zerava world[].active, e o parseRx do seguidor faz
    "if(active) lastMs = mil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
2026-08-01 docs: registra a bancada, as correcoes e a mudanca de prioridade do PPS
    CHANGELOG: secao nova com os quatro bugs do tdma_core.h e os seis do grupo_ws,
    com os numeros medidos, mais o que ficou registrado e nao corrigido (vao sem
    catch-up, FORA DO TRAJETO de quem entra atras, MAXN=8 contra os 25-50 nos do
    plano, roster ausente na pilha nova, resolucao do trajeto ditada pelo frame).
    CLAUDE.md: a REGRA DURA sobre o grupo_ws agora diz que ele FOI alterado a pedido
    do usuario, e avisa que nada foi gravado - gravar e conferir e o primeiro passo ao
    pegar as telas. Terceira secao para a bancada web, com os tres comandos de
    verificacao e o aviso de rodar o audit.js depois de mexer no firmware. A tare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
2026-08-03 RETOMAR: ordem recomendada de trabalho no topo (e conserta caminhos
    Os comandos da secao anterior tinham caracteres de controle no lugar das barras
    invertidas (\b virou backspace, \a bell, \t tab) - o bloco powershell estava
    inutilizavel. Reescrito.
    Secao nova com a ordem por risco e custo:
    1. gravar o grupo_ws e andar com as telas - o unico firmware validado em campo
    levou 7 correcoes que compilam e nunca rodaram. Registra a ressalva: com
    P2P=1 so parte delas e exercitada; slotDue, cor por slot e alerta multi-peer
    precisam de 3+ nos no modo grupo.
    2. tdma_selftest numa tela - valida no silicio o que mudou no tdma_core
    (frameBase, recuo do air-time, isAnchor). O tdm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
2026-08-12 docs: MONTAGEM.md, passo a passo de bancada do E22 + telas P4 + GPS
    Pesquisa em fonte primaria (manuais Ebyte/Semtech, esquematicos Waveshare
    das tres placas, datasheet ESP32-P4, Res. ANATEL 680/2017). Achados que
    mudam decisoes ja tomadas:
    - setCurrentLimit(140) DEPOIS de setOutputPower: sem isso o radio entrega
    19,6 dBm em vez de 29,4, silenciosamente. Corrigido tambem no CLAUDE.md.
    - TCXO e 2,2 V (manual V1.2 de 2026), nao 1,8. E XTAL=true esta errado
    para este modulo, que TEM TCXO. Armadilha do CLAUDE.md corrigida.
    - As telas P4 de 5" e 7" (720x1280) tem header identico; a 7B (1024x600)
    usa 2x JST-PH 12 vias e nao expoe 5V no header (usar o conector CAN).
    - GPIO 46/47/48 ficam no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
2026-08-12 Renomeia o projeto para MTS - Minhoca Trail System
    Repositorio agora e publico e se chama minhoca-trail-system. O GitHub
    mantem redirect do nome antigo, entao links e clones antigos continuam
    funcionando.
2026-08-12 tdma_core: fecha o bug de grade GPS x UTC e corrige o drift de holdover
    Dois defeitos achados na pesquisa de fonte primaria desta rodada. Nenhum
    dos dois quebra a rede HOJE; os dois quebram exatamente quando o projeto
    escalar para o alvo de 25-50 nos.
    1) GRADE DE TEMPO (tdma_core.h:201, latente)
    tdmaUsInFrame faz (anchorSec % frameSecs), o que pressupoe que todos os
    nos rotulam o segundo na MESMA grade. Existem duas - GPS e UTC - e elas
    diferem 18s inteiros. A borda do pulso e a mesma nas duas; o rotulo nao.
    O default de fabrica do u-blox no CFG-TP5 e grade GPS; o ATGM336H alinha
    em UTC.
    Se um no rotular em UTC e outro em GPS, os frames se deslocam de
    (18 % frameSecs) segundos - colisao t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
    [tdma_core.h, tdma_selftest.ino, tdma_test.ino]
2026-08-12 p4: primeiro sinal de vida na tela de 5" - 7/7 conferem, TDMA 61 PASS
    Primeira vez que codigo do projeto roda num ESP32-P4. Nenhum periferico,
    so a placa e o cabo USB.
    build.ps1 ganhou -Board p4. O core esp32 3.3.11 ja suporta P4 (o
    PLANO_IMPLEMENTACAO_MESH dizia que o Arduino-P4 era beta; nao e mais),
    entao a fase 4 pode comecar em Arduino e migrar para ESP-IDF depois, em
    vez de trocar as duas coisas de uma vez.
    firmware/p4_hello: sketch de primeira luz. Nao so imprime - COMPARA o
    medido com o que a pesquisa de datasheet prometeu, e imprime os dois lado
    a lado. Foi assim que ele achou o erro abaixo.
    MEDIDO (tela de 5", COM8):
    ESP32-P4 rev 103 (v1.3), 2 nucleos @ 360 MHz, SDK v5.5.5
    P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
2026-08-12 p4: painel identificado (HX8394), DSI/DPI de pe, vendor init ainda trava
    Bring-up da tela de 5" em Arduino + LovyanGFX. Metade do caminho andada, e a
    metade que falta esta documentada em vez de escondida.
    O QUE FUNCIONA
    - Bus_DSI sobe: 2 lanes, LDO ch3 2500 mV, sem erro
    - DPI + framebuffer de 1,8 MB alocam na PSRAM (32 -> 31,7 MB livres)
    - tft.init() retorna OK em 343 ms com um Panel_DSI cru
    - backlight acende (BL_EN GPIO33 + PWM GPIO26)
    O QUE NAO FUNCIONA
    - a sequencia de fabricante do painel trava dentro de
    esp_lcd_panel_io_tx_param, e o comando em que trava MUDA a cada build
    (L1[00] 0xB2, depois L0[15] 0xBD, depois L0[11] 0xC0) conforme o codigo
    em volta muda. Sem a sequencia, a t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
2026-08-12 mts_p4: tela acesa, abertura com a logo, tela inicial e configuracao
    PAINEL RESOLVIDO. O bloqueio era a POLARIDADE DO RESET: nesta placa o RST
    (GPIO27) e ATIVO-ALTO, e eu terminava o pulso em HIGH achando que soltava.
    O painel ficava preso em reset, mudo. E painel mudo trava o barramento em
    vez de dar erro: o esp_lcd_new_panel_io_dbi liga ACK por comando (fixo, sem
    opcao), entao o host espera resposta a cada comando; sem resposta a FIFO
    enche e o HAL gira num while() sem timeout. Por isso o comando em que
    travava MUDAVA a cada build - era a FIFO saturando em ponto diferente, nao
    um comando venenoso (esp-idf #15137, #15358, #18194).
    Confirmado por duas fontes independentes: o BSP da Waveshar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
    [mts_p4.ino, splash.h, teclado.h, ui.h]
2026-08-12 mts_p4: fluxo de grupo (criar/entrar com codigo) e conserto do desenho
    FLUXO DE GRUPO, como o usuario definiu
    - CRIAR: o aparelho propoe "Grupo do <nome do carro>" e sorteia um codigo de
    5 digitos. O nome e editavel no teclado; o codigo e a senha que o dono
    repassa. Quem cria vira lider.
    - ENTRAR: lista os grupos por perto (cartao com lider, numero de carros e
    barras de sinal); ao escolher, pede o codigo num teclado numerico.
    - A lista e SIMULADA e esta rotulada como tal na propria tela. Grupo de
    verdade precisa de dois nos que se ouçam.
    DESENHO: tres tentativas ate acertar o principio
    1) limpava a tela a cada toque -> piscava preto
    2) sprite de tela cheia, push por toque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
2026-08-12 mts_p4: sala de espera, tela de trilha e retomada apos religar
    Como o usuario definiu o fluxo:
    - CRIAR abre a SALA DE ESPERA. O codigo de 5 digitos fica grande e permanente
    (o dono precisa ditar isso e nao pode depender de ter anotado em outro
    lugar) e a lista de quem entrou cresce ao lado. ABRIR TRILHA nao fecha o
    grupo: quem chegar depois entra com o mesmo codigo.
    - Na TRILHA o codigo continua a vista, pelo mesmo motivo.
    - SAIR DA TRILHA pede confirmacao: e destrutivo e o dedo escorrega.
    RETOMADA APOS RELIGAR (sessao.h)
    Se o aparelho desligar no meio da trilha - bateria solta, cabo que pulou,
    reset - ele volta DIRETO para a tela da trilha, pulando o menu. Numa trilha
    isso nao e conf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
    [grupo.h, mts_p4.ino, sessao.h, ui.h]
2026-08-12 mts_p4: tela da trilha vira mapa de tela cheia com o minimo por cima
    Layout refeito a pedido do usuario. A regra que passa a valer nesta tela:
    o MAPA E A TELA INTEIRA, e tudo o mais flutua no canto ocupando o minimo.
    Numa trilha o motorista olha o caminho; nome de grupo, codigo e lista de
    carros sao consulta rapida, nao conteudo.
    - fora o cabecalho "MTS": nesta tela quem manda e o grupo, nao a marca
    - canto superior esquerdo: so o nome do grupo. O codigo aparece SO PARA O
    LIDER - e ele quem dita o numero, seguidor nao tem o que fazer com ele
    - canto superior direito, encostado: os OUTROS carros com cor, nome e
    distancia. Eu nao apareco (sou o centro do mapa, distancia sempre zero) e
    n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
2026-08-12 ui: modo dia e modo noite, pela norma e nao por gosto
    Pesquisa em fonte primaria (arquivos de estilo do Organic Maps e do
    Protomaps, IHO S-52 Ed.6.1.1, ISO 15008:2017, NSMRL Rep.1036, Webvision).
    A CONVENCAO, confirmada nos arquivos
    DIA = fundo claro, feicoes escuras
    NOITE = fundo escuro, feicoes claras
    IHO S-52 sec.2.2.1 exige "imagem negativa da carta a noite, para nao
    prejudicar a visao noturna". O Organic Maps mantem os mesmos 210 nomes de
    cor em dois arquivos: a MATIZ nunca muda, o que inverte e a luminancia em
    relacao ao fundo.
    Motivo de cada lado: a noite a vista leva 30-40 min para se adaptar ao
    escuro e uma tela clara destroi isso (alvo ~1 cd/m2, tres normas
    convergem). De d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
2026-08-13 mts_p4: mapa vivo e a estrutura pronta para GPS, radio e cartao
    Tres arquivos novos, desenhados para que ligar o hardware seja virar uma
    chave e nao reescrever tela.
    hardware.h - pinos e CHAVES DE RECURSO
    MTS_TEM_RADIO / MTS_TEM_GPS / MTS_TEM_SD, hoje em 0. Todo o firmware roda
    simulado. Ao soldar cada peca, vira a chave dela.
    Pinagem do Estudo 2, a MESMA nas tres placas P4 - so o conector muda.
    SPI2 no conjunto IO MUX ALTERNATIVO (28-31): o principal (6-11) esta todo
    ocupado nestas placas. Registrado o veto a 46/47/48 (banco do LDO) e a
    34-38 (strapping). Parametros do radio do Estudo 1, cada um com o motivo.
    mundo.h - a FRONTEIRA entre a tela e a origem do dado
    world/trajet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
2026-08-13 mapa: refeito depois de estudar o desenho do grupo_ws
    O usuario apontou que o mapa das telas S3 estava melhor que a minha
    primeira versao. Estava mesmo. Cinco coisas que o grupo_ws fazia e eu nao:
    1. ESTRADA, nao linha. Cada trecho e contorno grosso escuro + nucleo por
    cima, como todo estilo de mapa desenha via.
    2. TRES ESTADOS COM ESPESSURA diferente, nao so cor - codificacao
    redundante sobrevive ao sol e ao daltonismo:
    falta andar (roxo) 11/5 px o mais grosso: e para onde voce vai
    ja percorrido (azul) 8/3 px fino: e memoria, nao instrucao
    trecho em alerta (verm) 13/7 px o mais grosso de todos
    3. VAO VIRA PONTE TRACEJADA. Dois pontos a mais de 40 m = perda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
2026-08-13 ui: troca de dia/noite instantanea
    Nao havia transicao no codigo - era o desenho APARECENDO enquanto pinta. O
    painel e framebuffer: o video le o mesmo endereco que a gente escreve, entao
    da para ver a tela virando de cima para baixo. Le-se como suavizacao; e
    lentidao visivel.
    Na trilha havia um agravante: o toque so marcava o tema novo e o mapa repinta
    a cada 180 ms, entao ficava um instante sem nada acontecer.
    Conserto (trocaTema em ui.h): apaga o backlight, repinta no escuro, acende. O
    usuario ve o quadro novo pronto e nunca o meio do caminho - mesmo truque da
    abertura, custa os ~15 ms do redesenho. E o toque repinta na hora, sem esperar
    o proximo quadro.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
2026-08-13 ui: fora o sprite de tela cheia - ele custava 719 ms por quadro
    MEDIDO nesta placa, e o numero explica cada reclamacao desta sessao:
    fillScreen direto ............ 16 ms
    desenhar dentro do sprite .... 14 ms
    pushSprite de 1280x720 ....... 719 ms <-- 45x mais lento
    O pushSprite copia PSRAM para PSRAM pixel a pixel, sem caminho rapido na
    LovyanGFX para este painel. Era ELE a "transicao de PowerPoint": cada quadro
    do mapa custava 0,7 s, e a troca de tema tambem.
    Eu introduzi esse sprite para consertar a piscada preta e defendi ele duas
    vezes, inclusive escrevendo no codigo que "aqui o sprite finalmente se
    justifica" quando o mapa entrou. Estava errado nas duas: ele nunca se
    justific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
2026-08-13 mapa: fim da piscada - blit sem rotacao do painel
    Resolvido por MEDIDA, depois de tres tentativas erradas empilhadas (buffer,
    apagar o backlight, girar o painel com conversao de toque chutada - esta
    ultima chegou a trancar o usuario dentro da tela, porque nem o SAIR
    respondia).
    OS NUMEROS QUE DECIDIRAM, medidos nesta placa:
    fillScreen direto ............... 16 ms mas pisca
    quadro completo direto .......... 33 ms pisca
    pushSprite COM o painel girado .. 719 ms inutilizavel
    pushSprite SEM rotacao do painel 73 ms e NAO pisca
    Os 719 ms eram a rotacao: girado, a copia transpoe pixel a pixel. Entao o
    PAINEL fica na orientacao nativa (720x1280) e quem gira e o SPRITE -
    confirma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
2026-08-25 mapa: pipeline completo - OSM+SRTM viram cartao de trilha
    tools/mapa: vetor.py (OSM .pbf -> pacote vetorial por setores, 3 niveis de
    detalhe, u16 normalizado - decode de 2 shifts no caminho do quadro),
    baixa_relevo.py + relevo.py (SRTM 90 m -> blocos int16), grava_cartao.py
    (particiona o cartao: FAT32 + MTSVECT1 + MTSDEM01, com validacao por CRC32
    e trava de seguranca por barramento/tamanho de disco).
    firmware: vec_pack.h e dem_pack.h leem os pacotes por setor bruto, sem
    filesystem; vec_selftest roda em qualquer ESP32.
    Medido com o Brasil inteiro (2026-08-25): 2,1 GB de OSM -> brasil.vec de
    1.228 MB (332k setores, leitura p50 13-15 ms) + brasil.dem de 3,90 GB.
    Os pacotes gerados moram em D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
2026-08-25 mts_p4: o firmware da fase P4 completo - mapa, radio TDMA, GPS, UI
    O aparelho inteiro nas telas Waveshare ESP32-P4 (5" e 7B, MTS_PLACA):
    - mapa vetorial offline do cartao (mapa_fundo.h + sd_setor.h), heading-up
    por matriz 2x2, rota do lider 15/9 px, alerta fim-a-fim
    - radio.h: SX1262 em TDMA (tdma_core.h), timestamps de 64 bits na ISR,
    ancora por beacon ou PPS do GPS, watchdog de TX preso com re-init total,
    potencia por aparelho na NVS (comando p<n>), deteccao de conflito de slot
    - gps.h: NMEA + PPS no IO2 (a ancora definitiva do TDMA)
    - UI de painel de instrumentos: cartoes CRIAR/ENTRAR, configuracao com
    seletor de slot na tela, tela de WiFi (scan ordenado e sem repeticao,
    PROCUR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
2026-08-25 frota: atualizacao pela internet - as telas se atualizam de qualquer WiFi
    Servidor de release estatico na Vercel (https://mts-ota.vercel.app):
    version.json e o manifesto (versao, arquivo, md5, bytes); a raiz e um
    painel de status; o binario sobe com o nome versionado para o CDN nunca
    servir binario velho com manifesto novo.
    Publicar = subir MTS_VERSAO no hardware.h + tools\publica_ota.ps1
    (compila, calcula MD5, escreve o manifesto, vercel deploy). As telas
    ligadas checam a cada 15 min na tela inicial (nunca na trilha) e se
    atualizam sozinhas - provado ao vivo: tela C foi de v4 para v5 sem cabo.
    A licao cara do dia, registrada no wifi_ota.h: o TLS do esp_hosted trava
    em respostas maiores qu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
2026-08-25 bancada: diagnostico de chicote, estudos P4 e espelhos do TDMA
    - chicote_probe: prova cada fio do chicote do radio sem firmware de verdade
    (escada de reset/BUSY, GetStatus ativo, testemunha de BUSY, permutacoes) -
    foi ele que separou "P3 sem contato" de "modulo defeituoso" nas 3 telas
    - p4_dsi_puro / p4_tela7 / p4_sd: estudos isolados de painel DSI e cartao
    que viraram o LGFX_P4_LCD7.h e o sd_setor.h do mts_p4
    - e22_ping: nota do defeito de fabrica (XOSC_START_ERR acima de ~6 dBm em
    2 dos 3 modulos; escada de potencia, diagTx via GetDeviceErrors)
    - tdma_core.h + tdma_selftest: janela de TX com air-time, TTL por frame,
    teste [3b]; 66 PASS no silicio do P4
    - bancada web: espelhos das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
    [chicote_probe.ino, e22_ping.ino, p4_dsi_puro.ino, p4_sd.ino, p4_tela7.ino, tdma_core.h, tdma_selftest.ino]
2026-08-25 docs: montagem, pinagem oficial, plano de melhorias e o diario da frota
    - MONTAGEM.md: passo a passo de bancada com a pinagem OFICIAL do E22-M
    (manual Ebyte V1.2) e dos conectores da tela 7B (esquematico Waveshare) -
    as 5 coisas que queimam, na ordem
    - PINAGEM.md + imagens: mapa pino a pino das duas telas P4
    - PLANO_MELHORIAS.md: 6 fases pos-campo (protocolo, confiabilidade,
    funcionalidades estilo Google Maps de grupo, otimizacao medida, visual,
    testes) + item 11: painel de frota pela internet
    - CHANGELOG: o dia 2026-08-25 inteiro - mapa regenerado, cartao da tela C,
    giro da caixinha, WiFi/teclado refeitos, frota OTA com a armadilha do TLS,
    rede de 3 nos com PPS validada
    - CLAUDE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
2026-09-29 mts: firmware reestruturado para a P4-7", mts_campo v101 e dados do teste de campo
    - firmware/mts/: nucleo sem hardware + hal da P4-7" + aplicacao, com
    parametros centralizados em core/params.h. Compila (1089944 B), nunca
    rodou em placa. Pacote novo nao e compativel com o v101.
    - firmware/mts_campo/ (v101), mts_selftest, catchup_selftest
    - dados_campo/ e tools/campo/: logs do teste FaustoA x gino e cruzamento
    - docs: estudo E22, plano 7B, protocolo fase 0, auditoria do radio
    - bancada: testes do nucleo, catch-up e eleicao de ancora
2026-09-29 mts: correcoes da revisao pos-queda - boot-loop, catch-up travado, potencia
    - radio mudo: GetStatus cru antes do begin() e WDT pausado nele (o begin()
    de um chip mudo leva >= 10 s = WDT; era boot-loop com o 5V do E22 caido)
    - catch-up: lider anuncia o ponto mais antigo que guarda (piso) e o
    seguidor manda o topo; vao irrecuperavel nao prende mais o ack, e
    seguidor surdo nao dita mais o bloco da frota
    - potencia: modo seguro vira so alarme; migracao so sobe; 'p30' nao vira
    3 dBm; troca com TX em voo e aplicada depois
    - rastro zerado ao abrir a trilha; caixa-preta fecha a cada etapa;
    holdover 4 quadros; km[] com rota cheia; janela de TX protegida; lista
    com lider primeiro; contador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
2026-09-29 mts: barramento DSI proprio - clock do PHY pela revisao do chip
    A LovyanGFX do PC tem um patch manual (PATCH REDEA) que usa XTAL no PHY
    DSI; nas telas P4 eco2 (rev 1.3) isso da abort() no esp_lcd_new_dsi_bus
    e boot-loop de 1,2 s. hal/bus_dsi.h herda do Bus_DSI e reescreve so o
    init(), sem tocar na biblioteca. Medido na tela gino (COM11): antes 124
    reinicios em 150 s; depois 150 s no ar, mapa e diario funcionando.
2026-09-29 mts: radio que nao subiu no boot e tentado de novo a cada 3 s
    Antes a rede desistia para sempre (r.ok = false). No carro, a tela pode
    ligar antes do 5V do E22; agora o radio entra sozinho quando a energia
    chega, e o diario registra quanto tempo depois do boot.
2026-10-01 mts: ENTRAR lista os grupos no ar - entra com um toque
    No teste de 2026-09-30 as duas telas tocaram em CRIAR e ficaram em grupos
    diferentes; o radio recebia o outro e descartava por ser de outra sala.
    Agora a rede anota de quem eram esses pacotes (core/vizinhos.h: sala, nome
    do lider pelo roster, sinal, carros) e a tela ENTRAR mostra a lista; o
    toque entra pelo hash, gravado na sessao como "#79FD" (protoSalaDoCodigo)
    para o RETOMAR. Digitar o codigo continua num botao.
    Tambem: diarios do teste em dados_campo/*_2026-09-30 e os scripts
    tools/campo/resumo_mts.py e cruza_mts.py.
2026-10-01 mts: o icone do lider sumia na tela do seguidor - idade de carimbo dava a volta
    No servico(), 'agora' era lido antes do radio; o pacote recebido carimbava
    o carro com um millis() posterior, e o frotaEnvelhece calculava
    agora - ultimoMs em uint32_t: ~4 bilhoes, carro apagado logo depois de
    chegar. O tracado sobrevivia (mora na rota). No diario do carro de
    2026-09-30 a tela do Gino ficou com carrosAtivos = 1 o teste inteiro.
    core/tempo.h: tempoDesde() trata carimbo no futuro como 'agora mesmo';
    todo o core passa por ela, e o servico rele o relogio depois do radio.
    mts_core_test reprova subtracao crua no core; mts_selftest reproduz o bug
    na placa (51/51).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
2026-10-01 simulador: o firmware/mts de verdade, varias telas, no PC (tools/sim)
    Em 2026-09-30 um dia de teste foi perdido por um bug (icone do lider
    sumindo na tela do seguidor) que passou por todos os testes: eles testavam
    pedacos, nenhum ligava duas telas. O simulador compila core/app/hal reais
    (so radio e cartao sao falsos), uma copia por tela em namespaces, com
    relogio, GPS (PPS + NMEA), NVS e diario proprios, e um 'ar' calibrado com
    o carro (alcance ~400 m com antena dentro). O codigo leva tempo: sem o
    custo de CPU o bug do icone passava verde - medido.
    6 cenarios (grupo pela lista, perder sinal e voltar, lider reinicia,
    radio tarde, grupos trocados, tres carros): 33/33. Com o bug do icone
    recol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
2026-10-01 mts: o que o simulador achou - radio de fabrica, icone sem GPS, catch-up
    13 cenarios no simulador (7 novos: gps_perde, alerta, trilha_longa,
    perda_pesada, quatro_carros, rapido, entra_tarde), todos passando. Achados:
    - radio que perde o 5V ENTRE dois TX volta de fabrica: transmite e escuta
    errado sem travar nada (o vigia nao via). radioHwConfigOk() a cada 5 s
    (GetPacketType = LoRa) e rebegin.
    - GPS do lider caindo apagava o icone dele no seguidor: o pacote sem fix
    agora mantem o ultimo ponto (vazado, SEM GPS); frotaSinal mede o radio.
    - catch-up: a 40 km/h, sem perder pacote, 173 de 352 quadros iam em
    preenchimento (o quadro do roster abria buraco) e a frente atrasava.
    Agora o blo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
2026-10-01 mts: modo consulta quando o DIO1 nao chega + comandos de bancada por cabo
    Bancada de 2026-10-01: na FaustoA o chip terminava o TX (o vigia confirmou
    pelo SPI) e o pino DIO1 da placa ficava em 0 - o sinal nao chega ao GPIO 50
    (fios aparentemente bons; suspeita de contato/solda). A tela transmitia mas
    NAO RECEBIA NADA, e o fim de cada TX so era visto pelo vigia aos 617 ms.
    Agora, apos 3 TX seguidos sem interrupcao, a rede entra em MODO CONSULTA:
    le os eventos do chip pelo SPI a cada volta, avisa na tela (RADIO SEM DIO1)
    e no diario. Na placa: rx voltou (0 -> 12 em 90 s), air 620 -> 217 ms.
    Simulador: cenario dio1_morto (pegou um bug do proprio patch: o TX_DONE
    forcado pelo vigia zerava a cont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
2026-10-01 hardware: placa do radio E22 para a traseira da tela de 7" (40 x 70, face simples)
    E22-900M30S + J1/J2 (PH2.0 12 vias, mesma numeracao do P3/P1 da tela) + GPS por
    cabo (TX/RX/PPS/GND/3V3) + entrada 5,3 V em XH, desacoplamento 220u/10u/100n nos
    pads 9/10 e pull-down em TXEN/RXEN. Gerada por gera_placa.py com DRC (folga
    >= 0,4 mm, redes inteiras contando os 4 jumpers, cada pino na rede certa).
    Arquivos da laser sem espelhar (lado do cobre), 3 mm de sobra e linha de corte.
2026-10-01 hardware: placa do radio v2 - nomes gravados, guias de montagem, mecanica conferida
    - serigrafia (laser_serigrafia): o nome de cada fio em pe ao lado de cada pino, no
    lado sem cobre, pino 1 marcado, titulos J1/J2 -> P3/P1, GPS com os nomes do modulo
    - guias novos: lado dos conectores, lado do cobre, e o que liga em que (P1/P3 com
    GPIO, GPS fio por fio, step-down, antena); montagem.png saiu
    - carcacas reais do PH/XH (footprint KiCad) mostraram 3 colisoes: furo do JP3 debaixo
    do J1, JP1 por cima do J2, XH encostando no C1. TXEN agora contorna a placa pela
    borda (JP1 nao existe mais), JP3 vira fio do lado do cobre, JP4 encurta para 3 mm
    - DRC confere a mecanica e a serigrafia; texto do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
2026-10-01 hardware: placa do radio v2 - sem cobre sob o E22, antena soldada, placa montada
    - Sem plano de terra debaixo do E22: placa caseira nao tem mascara de solda e
    qualquer metal exposto no fundo do modulo daria curto. O terra de cima e o de
    baixo passam a se juntar pelos pads de terra do proprio modulo; o DRC trata
    esses pads como um no so.
    - Antena soldada (vivo no pad 21, malha no 22) no lugar do IPEX nos guias e no
    README.
    - guia_4_placa_montada.png: os dois lados com cada peca desenhada no lugar.
    - final/: o que vai para a laser (DXF, BMP a 1200 dpi, regua) e as previas.
2026-10-01 hardware: placa do radio - estudo das pecas, cobre de volta sob o E22, vao de 1,2 mm
    - ESTUDO_PECAS.md: oito esquematicos abertos com o E22-900M30S, manuais Ebyte,
    SX1262 e ESP32-P4, e simulacao do hot-plug. C1/C2/C3/R1/R2 ficam; C1 passa a
    16 V/105 C baixo ESR, C2 a X7R 16-25 V; step-down em 5,0-5,1 V.
    - O plano de terra volta para debaixo do E22 (manual Ebyte E22-M V1.5, 4.1) e
    sai a regra de terra "por dentro do modulo" do DRC: o terra e uma peca so.
    - Debaixo do modulo, o vao entre pad de sinal e terra sobe de 0,6 para 1,2 mm,
    para tolerar o modulo soldado um pouco torto. zoom_vao_e22.png mostra.
2026-10-02 hardware: placa do radio v3 - sem furo, tudo do lado do cobre, fio direto
    O lado da fibra cola na traseira da tela, entao nada pode atravessar a placa:
    - Sem conector: os cabos do P1 e do P3 chegam cortados e cada fio solda num pad
    com o numero do pino da tela gravado. O GPS solda no mesmo pad do fio do P3.
    - Os pads ficam na ordem dos pinos do E22: nenhuma trilha cruza, zero jumper.
    - Nomes vazados no plano de terra; o DRC confere o numero de cada pad contra a
    pinagem da tela e que nenhum nome encosta em trilha.
    - Pads de terra com alivio termico (anel com 4 pontes): visiveis e soldaveis.
    - C1 vira eletrolitico SMD. Sai a gravacao do outro lado, os furos e os
    guias da v2; entram guia_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
2026-10-02 hardware: placa do radio - o gerador ja sai com o BMP da laser e atualiza final/ so com DRC OK
2026-10-02 hardware: placa do radio - so C1, C2 e R1, mais espaco, manual de montagem em PDF
    - Segundo estudo (ESTUDO_PECAS.md, 6): dentro do E22 o TXEN liga o EN do buck
    TLV62568 do PA, que a TI proibe flutuando -> R1 fica. O RXEN so liga o LDO do
    LNA -> R2 sai. O C3 de 100 nF e redundante com o C2 e os ceramicos internos
    -> sai. Dados de campo: sem capacitor estavel a 14 dBm, trava a 18 -> C1 fica.
    - R1 passa para a borda com 1,2 mm ate o RXEN; C2 colado nos pinos 10/11; pads
    1,8 x 1,5 nos 1206. Folga minima sobe de 0,50 para 0,60 mm.
    - manual.py gera MONTAGEM_placa_radio.pdf: lista de pecas com icone e funcao,
    fabricacao, onde vai cada peca (numerada), ordem de solda, ligacoes, testes e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
2026-10-02 hardware: placa do radio - pecas comuns de perna (R1 1/4 W, C2 ceramico 106, C1 eletrolitico)
    A placa nao tem furo: as pernas dobram em L e o pe solda em cima do pad.
    - R1: resistor 1/4 W deitado ao longo da borda, pads a 10,16 mm (passo de 0,4").
    - C2: ceramico multicamada de perna, em pe, pads 2,0 x 2,0.
    - C1: eletrolitico comum em pe, pernas abertas ate os pads (2,6 x 2,4).
    Guias, manual em PDF e README mostram e descrevem as pecas de perna.
2026-10-08 mts v201: quadro de 2 s x 4 slots - o lider deixa de ficar lento no seguidor
    No carro de 09-30 a posicao do lider chegava no seguidor a cada 6 s no melhor
    caso, 27 % dos intervalos passaram de 12 s e o icone ficou congelado/vazado 35 %
    da trilha. Com ate 4 carros (decisao do usuario) o quadro volta a 2 s.
    - TDMA 2 s x 4 slots de 500 ms; protocolo v3 (v200 no ar colidiria em silencio);
    config esquema 3 com faixa na tela para slot 4..7 que foi para 0
    - prazos em segundos: holdover 24,5 s (12 quadros), ack 16 s, extrapola 8 s,
    sinal velho 20 s, lista de grupos 30 s
    - ruido de fundo medido em slot livre (nao ha mais slot fixo vazio)
    - orcamento: a pintura do mapa respeita a janela de TX abe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
2026-10-08 sim: 7 cenarios da revisao adversaria do v201 (pintura, PPS, ruido, v200, cfg)
    Modelo de pintura configuravel por cenario (periodo, custo quente/frio, pedido
    real ou como a tela_trilha.h pede), radioHwRssiInst falso que le o pacote mais
    forte no ar, NVS semeada "do v200", fantasma v200 no ar e campos novos no NoObs
    (orcamento, ruido, config, disciplina do PPS). Cada pintura sai no console como
    PINTA,ms,custoReal,custoPedido,usNoQuadro.
    O que os cenarios mostram (firmware d6bc6c0):
    - pintura_05s: com o custo conhecido a guarda nova segura (perdi 0 na trilha)
    - pps_laco_300: laco parado 300 ms a cada 4 s descarta o NMEA, zera o ppsRun e
    tira a rede da grade UTC (57 %/44 % do tempo em PPS, 7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
2026-10-08 mts (CANDIDATO): GPS_LACO_PARADO_MS 600 ms e GPS_PAR_PPS_MAX_US 700 ms
    Correcao proposta pela revisao do v201, NAO gravada em tela nenhuma. Com 300 ms,
    um quadro de mapa frio de 300 ms em cima da frase NMEA jogava fora o backlog, o
    par PPS do segundo se perdia e o tdmaOnPps zerava o ppsRun: 10 s limpos ate o
    PPS voltar. A 0,5 s de repintura isso nao convergia (pps_laco_300: 57 %/44 % do
    tempo em PPS, 4/7 trocas de fonte, 7 TX perdidos em 10 min). Limites seguros:
    frase do segundo T lida antes da borda T+1 nunca casa errado (laco < 880 ms);
    600/700 ms ficam dentro e cobrem o pior quadro frio. Com a mudanca: 100 %/100 %
    em PPS, 0 descartes, 0 trocas; os 21 cenarios e os 6 testes da bancada ver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
